YangYangyou-Zhang/OpenblH743VIT6/PPT/H743MINI_back.png

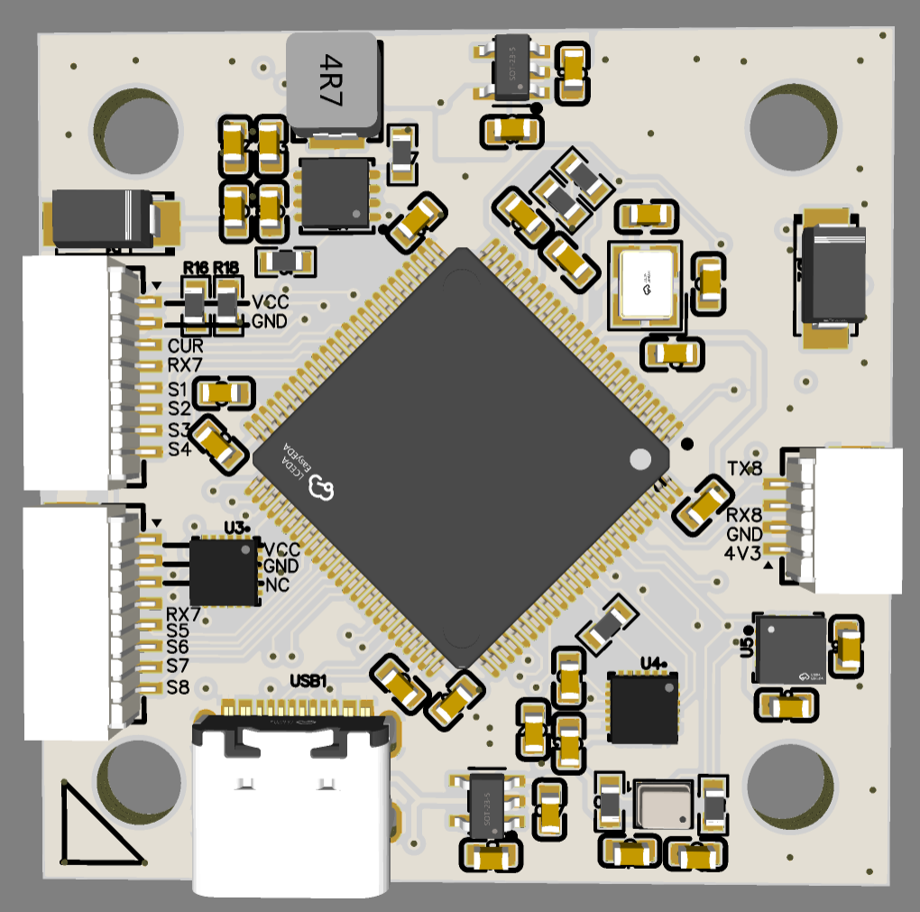
PPT/H743MINI_back.png
