YangYangyou-Zhang/OpenblH743VIT6/PPT/H743MINI_top.png

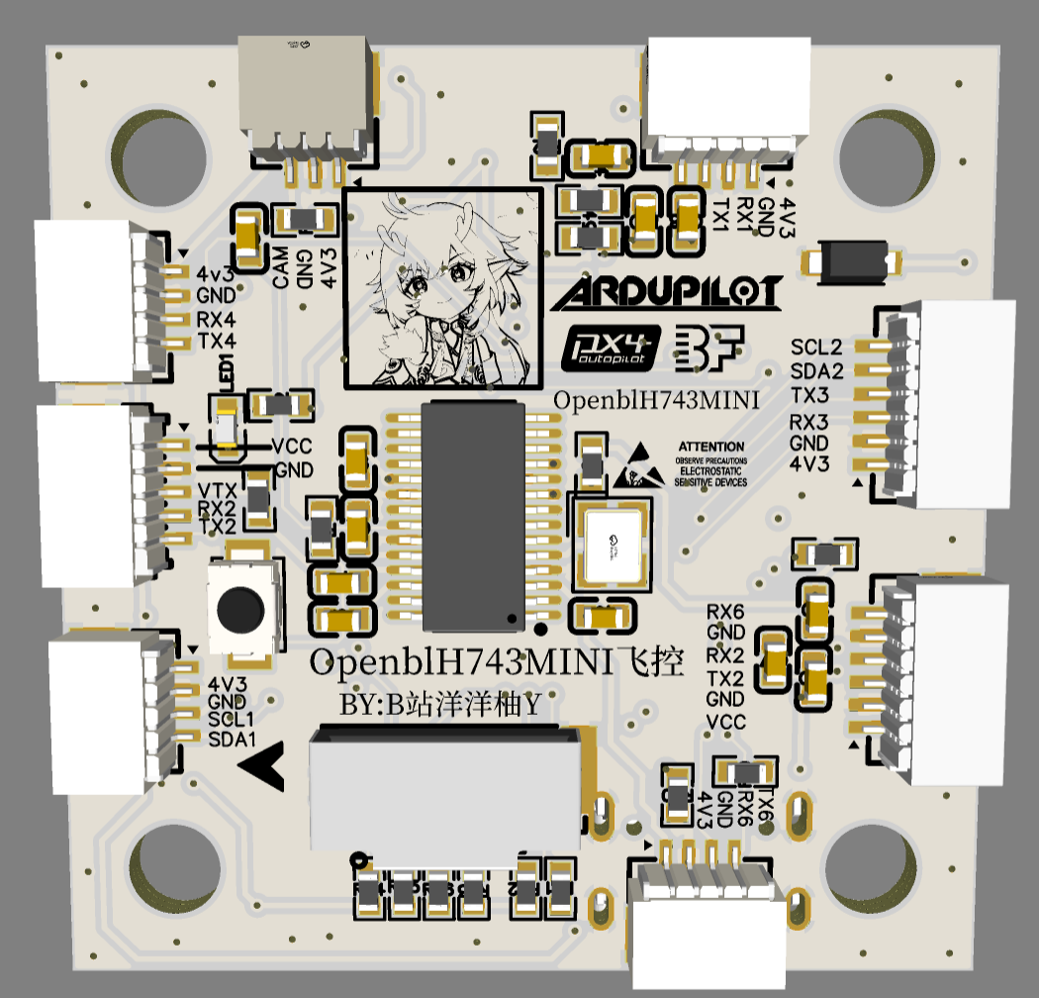
PPT/H743MINI_top.png
