YangYangyou-Zhang/OpenblH743VIT6/PPT/H743VIT6_back.png

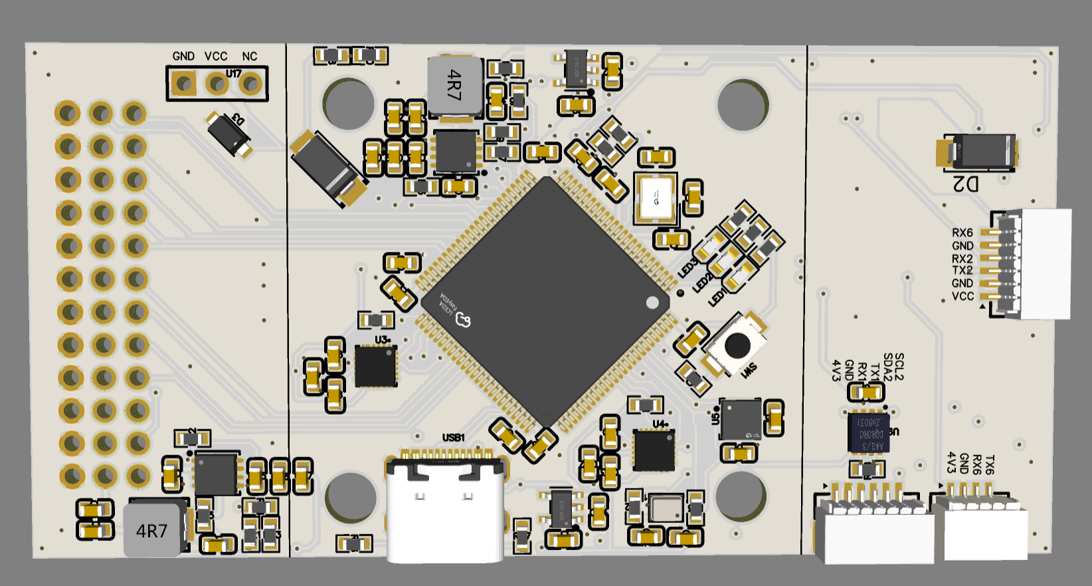
PPT/H743VIT6_back.png
