YangYangyou-Zhang/OpenblH743VIT6/PPT/H743VIT6_top.png

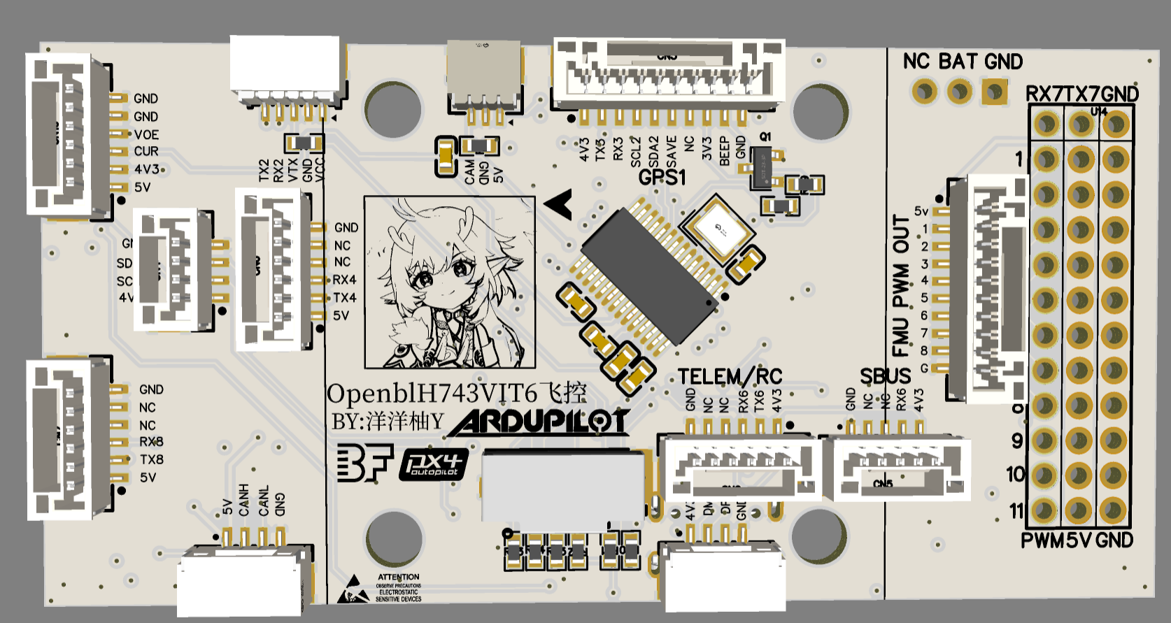
PPT/H743VIT6_top.png
