YangYangyou-Zhang/OpenblH743VIT6/Circuit_diagram电路图/BOM_OpenblH743MINI飞控板_2026-09-29.csv

ID | Name | Designator | Footprint | Quantity | Manufacturer Part | Manufacturer | Supplier | Supplier Part | Price
1 | SMFJ26CA | D2 | SMA_L4.3-W2.6-LS5.2-RD | 1 | SS56 | MDD(辰达半导体) | LCSC | C65009 | 0.323
2 | 10k | R3,R9,R10,R11,R5,R7,R8,R21,R22,R23,R24,R25,R26 | R0603 | 13
3 | 1k | R6,R18,R2 | R0603 | 3
4 | 1M | R13 | R0603 | 1
5 | 51k | R15,R16 | R0603 | 2
6 | 20r | R17 | R0603 | 1
7 | BX-SH1.0-4PWT | U12,U9,U11,U14,U8 | CONN-SMD_4P-P1.00_BX-SH1.0-4PWT | 5 | BX-SH1.0-4PWT | Bossie(博锡) | LCSC | C18077910 | 0.3961
8 | BX-SH1.0-8PWT | U16,U19 | CONN-SMD_8P-P1.00_BX-SH1.0-8PWT | 2 | BX-SH1.0-8PWT | Bossie(博锡) | LCSC | C18077914 | 0.6031
9 | 1u | C28,C35,C36,C37,C38 | C0603 | 5
10 | 100nf | C1,C2,C5,C6,C7,C8,C10,C12,C13,C16,C17,C18,C20,C21,C22,C23,C24,C25,C27,C31,C34 | C0603 | 21
11 | 2.2u | C9,C14,C19 | C0603 | 3
12 | 22pf | C11,C15 | C0603 | 2
13 | 10u | C26,C29,C30,C32,C33 | C0603 | 5
14 | 10uH | L1 | IND-SMD_L4.5-W4.1_TMPA0402SP | 1 | TMPC0402HP-100MG-Z02 | TAI-TECH(台庆) | LCSC | C305203 | 1.9166
15 | ME6211C33M5G-N | LDO1,LDO2 | SOT-23-5_L3.0-W1.7-P0.95-LS2.8-BL | 2 | ME6211C33M5G-N | MICRONE(南京微盟) | LCSC | C82942 | 0.3732
16 | STM32H743VIT6 | U2 | LQFP-100_L14.0-W14.0-P0.50-LS16.0-BL | 1 | STM32H743VIT6 | ST(意法半导体) | LCSC | C529058 | 46.39
17 | MPU6500 | U3,U4 | QFN-24_L3.0-W3.0-P0.40-BL-EP | 2 | MPU-6500 | TDK InvenSense(应美盛) | LCSC | C50278 | 32.58
18 | KH-TYPEC-16P | USB1 | USB-TYPEC-16P | 1
19 | 8MHz | X2 | CRYSTAL-SMD_4P-L3.2-W2.5-BL | 1 | XL2EL89CSI-KPIYLC-8M | YXC(扬兴晶振) | LCSC | C42400161 | 0.8126
20 | SS56 | D1 | SMA_L4.3-W2.6-LS5.2-RD | 1 | SS56 | MDD(辰达半导体) | LCSC | C65009 | 0.323
21 | QMC5883P | U5 | LGA-16_L3.0-W3.0-P0.50-BL_SQ | 1 | QMC5883P | QST(上海矽睿) | LCSC | C2847467 | 9.73
22 | SPL06-001 | U6 | SENSOR-SMD_SPL06-001 | 1 | SPL06-001 | Goertek(歌尔) | LCSC | C2684428 | 6.21
23 | MP9943GQ-Z | U7 | QFN-8_L3.0-W3.0-P0.65-BL | 1 | MP9943GQ-Z | MPS(芯源) | LCSC | C477821 | 17
24 | SMFJ26CA | D3 | SOD-123FL_L2.6-W1.7-LS3.6-BI | 1 | SMFJ26CA | RUILON(瑞隆源) | LCSC | C434860 | 1.0102
25 | 9.53k | R14 | R0603 | 1
26 | 75r | R1,R4 | R0603 | 2
27 | 41.2k | R12 | R0603 | 1
28 | 5.1k | R19,R20 | R0603 | 2
29 | BX-SH1.0-6PWT | U10,U17 | CONN-SMD_6P-P1.00_BX-SH1.0-6PWT | 2 | BX-SH1.0-6PWT | Bossie(博锡) | LCSC | C18077912 | 0.5119
30 | HYCW103-TF08-375B | U13 | TF-SMD_TF-021B-H265 | 1 | HYCW103-TF08-375B | 华宇创 | LCSC | C2962028 | 0.9181
31 | BX-SH1.0-5PWT | U15 | CONN-SMD_5P-P1.00_BX-SH1.0-5PWT | 1 | BX-SH1.0-5PWT | Bossie(博锡) | LCSC | C18077911 | 0.3558
32 | BX-SH1.0-3PWT | U18 | CONN-SMD_3P-P1.00_BX-SH1.0-3PWT | 1 | BX-SH1.0-3PWT | Bossie(博锡) | LCSC | C18077909 | 0.272
33 | 10uf | C3,C4 | C0603 | 2 | CGA0603X5R476M6R3JT | HRE(芯声) | LCSC | C6119831 | 0.7204
34 | AT7456E | U1 | TSSOP-28_L9.7-W4.4-P0.65-LS6.4-BL-EP-2 | 1 | AT7456E | 杭州中科微 | LCSC | C82351 | 21.02
35 | 27MHz-8pf | X1 | CRYSTAL-SMD_4P-L3.2-W2.5-BL | 1 | TAXM27M4RLBCCT2T | YJX(雅晶鑫) | LCSC | C164042 | 0.4455
36 | TS-1088-AR02016 | SW1 | SW-SMD_L3.9-W3.0-P4.45 | 1 | TS-1088-AR02016 | XUNPU(讯普) | LCSC | C720477 | 0.33
37 | LED_r | LED1 | LED0603-RD_1 | 1 | LED灯,0603 | null | LCSC | C9900014849
