YangYangyou-Zhang/OpenblH743VIT6/Circuit_diagram电路图/BOM_OpenblH743VIT6飞控板_2026-09-29.csv

ID | Name | Designator | Footprint | Quantity | Manufacturer Part | Manufacturer | Supplier | Supplier Part | Price
1 | ZX-GH1.25-4PLT | CN4 | CONN-SMD_ZX-GH1.25-4PLT | 1 | ZX-GH1.25-4PLT | Megastar(兆星) | LCSC | C46970427 | 0.5655
2 | ZX-GH1.25-6PLT | CN6,CN10,CN7,CN8 | CONN-SMD_ZX-GH1.25-6PLT | 4 | ZX-GH1.25-6PLT | Megastar(兆星) | LCSC | C46970429 | 0.6317
3 | ZX-GH1.25-10PLT | CN3,CN9 | CONN-SMD_ZX-GH1.25-10PLT | 2 | ZX-GH1.25-10PLT | Megastar(兆星) | LCSC | C46970433 | 0.8635
4 | ZX-GH1.25-4PWT | CN1,CN2 | CONN-SMD_ZX-GH1.25-4PWT | 2 | ZX-GH1.25-4PWT | Megastar(兆星) | LCSC | C46533577 | 0.4947
5 | 100nf | C1,C2,C5,C6,C7,C8,C10,C12,C13,C16,C17,C18,C20,C21,C22,C23,C24,C25,C27,C31,C34,C38,C41,C46 | C0603 | 24
6 | 10uf | C3,C4 | C0603 | 2 | CGA0603X5R476M6R3JT | HRE(芯声) | LCSC | C6119831 | 0.7204
7 | AT7456E | U1 | TSSOP-28_L9.7-W4.4-P0.65-LS6.4-BL-EP-2 | 1 | AT7456E | 杭州中科微 | LCSC | C82351 | 21.02
8 | 27MHz-8pf | X1 | CRYSTAL-SMD_4P-L3.2-W2.5-BL | 1 | TAXM27M4RLBCCT2T | YJX(雅晶鑫) | LCSC | C164042 | 0.4455
9 | 75r | R2,R6 | R0603 | 2
10 | 10k | R7,R30,R31,R32,R33,R34,R35,R5,R9,R10,R11,R12,R13 | R0603 | 13
11 | BX-SH1.0-5PWT | U13 | CONN-SMD_5P-P1.00_BX-SH1.0-5PWT | 1 | BX-SH1.0-5PWT | Bossie(博锡) | LCSC | C18077911 | 0.3558
12 | BX-SH1.0-3PWT | U16 | CONN-SMD_3P-P1.00_BX-SH1.0-3PWT | 1 | BX-SH1.0-3PWT | Bossie(博锡) | LCSC | C18077909 | 0.272
13 | HYCW103-TF08-375B | U11 | TF-SMD_TF-021B-H265 | 1 | HYCW103-TF08-375B | 华宇创 | LCSC | C2962028 | 0.9181
14 | S9014 | Q1 | SOT-23-3_L2.9-W1.3-P1.90-LS2.4-BR | 1 | S9014 | CJ(江苏长电/长晶) | LCSC | C2148 | 0.0786
15 | 1k | R29,R20,R1,R3,R4,R8 | R0603 | 6
16 | HC-GH1.25-5PLT | CN5 | CONN-SMD_HC-GH1.25-5PLT | 1 | HC-GH1.25-5PLT | HC(虹成电子) | LCSC | C53151909 | 0.3944
17 | 直插2.54 | U14 | 3*12PIN_2.54 | 1
18 | SS56 | D2,D1 | SMA_L4.3-W2.6-LS5.2-RD | 2 | SS56 | MDD(辰达半导体) | LCSC | C65009 | 0.323
19 | SMFJ26CA | D3 | SOD-123FL_L2.6-W1.7-LS3.6-BI | 1 | SMFJ26CA | RUILON(瑞隆源) | LCSC | C434860 | 1.0102
20 | 9.53k | R16 | R0603 | 1
21 | BX-SH1.0-6PWT | U10,U15 | CONN-SMD_6P-P1.00_BX-SH1.0-6PWT | 2 | BX-SH1.0-6PWT | Bossie(博锡) | LCSC | C18077912 | 0.5119
22 | BX-SH1.0-4PWT | U12 | CONN-SMD_4P-P1.00_BX-SH1.0-4PWT | 1 | BX-SH1.0-4PWT | Bossie(博锡) | LCSC | C18077910 | 0.3961
23 | 2.2u | C9,C14,C19 | C0603 | 3
24 | 22pf | C11,C15 | C0603 | 2
25 | 10u | C26,C29,C30,C32,C33,C36,C37,C39,C40 | C0603 | 9
26 | 10uH | L1,L2 | IND-SMD_L4.5-W4.1_TMPA0402SP | 2 | TMPC0402HP-100MG-Z02 | TAI-TECH(台庆) | LCSC | C305203 | 1.9166
27 | ME6211C33M5G-N | LDO1,LDO2 | SOT-23-5_L3.0-W1.7-P0.95-LS2.8-BL | 2 | ME6211C33M5G-N | MICRONE(南京微盟) | LCSC | C82942 | 0.3732
28 | LED_b | LED3 | LED0603-RD_1 | 1 | LED灯,0603 | null | LCSC | C9900014849
29 | STM32H743VIT6 | U2 | LQFP-100_L14.0-W14.0-P0.50-LS16.0-BL | 1 | STM32H743VIT6 | ST(意法半导体) | LCSC | C529058 | 46.39
30 | MPU6500 | U3,U4 | QFN-24_L3.0-W3.0-P0.40-BL-EP | 2 | MPU-6500 | TDK InvenSense(应美盛) | LCSC | C50278 | 32.58
31 | 单排母针-2.54mm-3P | U17 | 单排母针-2.54MM-3P | 1 | 单排母针-2.54mm-6P | 单排母针-2.54mm-6P |  | 单排母针-2.54mm-6P
32 | KH-TYPEC-16P | USB1 | USB-TYPEC-16P | 1
33 | 8MHz | X2 | CRYSTAL-SMD_4P-L3.2-W2.5-BL | 1 | XL2EL89CSI-KPIYLC-8M | YXC(扬兴晶振) | LCSC | C42400161 | 0.8126
34 | TS-1088-AR02016 | SW1 | SW-SMD_L3.9-W3.0-P4.45 | 1 | TS-1088-AR02016 | XUNPU(讯普) | LCSC | C720477 | 0.33
35 | 1u | C28,C35,C42,C43,C44,C45 | C0603 | 6
36 | LED_r | LED1 | LED0603-RD_1 | 1 | LED灯,0603 | null | LCSC | C9900014849
37 | LED_g | LED2 | LED0603-RD_1 | 1 | LED灯,0603 | null | LCSC | C9900014849
38 | 41.2k | R14,R21 | R0603 | 2
39 | 1M | R15,R22 | R0603 | 2
40 | 51k | R17,R18,R24 | R0603 | 3
41 | 20r | R19,R25 | R0603 | 2
42 | 7.68k | R23 | R0603 | 1
43 | 5.1k | R26,R27 | R0603 | 2
44 | 120 | R28 | R0603 | 1
45 | QMC5883P | U5 | LGA-16_L3.0-W3.0-P0.50-BL_SQ | 1 | QMC5883P | QST(上海矽睿) | LCSC | C2847467 | 9.73
46 | SPL06-001 | U6 | SENSOR-SMD_SPL06-001 | 1 | SPL06-001 | Goertek(歌尔) | LCSC | C2684428 | 6.21
47 | MP9943GQ-Z | U7,U8 | QFN-8_L3.0-W3.0-P0.65-BL | 2 | MP9943GQ-Z | MPS(芯源) | LCSC | C477821 | 17
48 | TJA1051TK/3,118 | U9 | HVSON-8_L3.0-W3.0-P0.65-BL-EP | 1 | TJA1051TK/3,118 | NXP(恩智浦) | LCSC | C124020 | 11.72
