YangYangyou-Zhang/OpenblH743VIT6/STL图纸/OpenblH743.SLDPRT

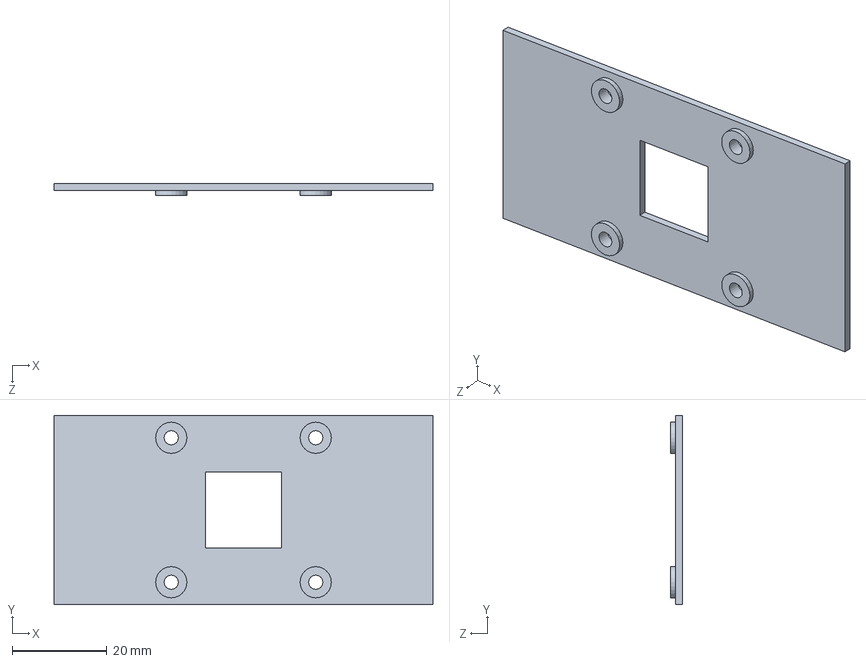
[picture p9: CAD file, 2026-10-23]
STL图纸/OpenblH743.SLDPRT
80.0 x 40.0 x 2.50 mm
