YangYangyou-Zhang/OpenblH743VIT6/STL图纸/钢网框4-8.SLDPRT

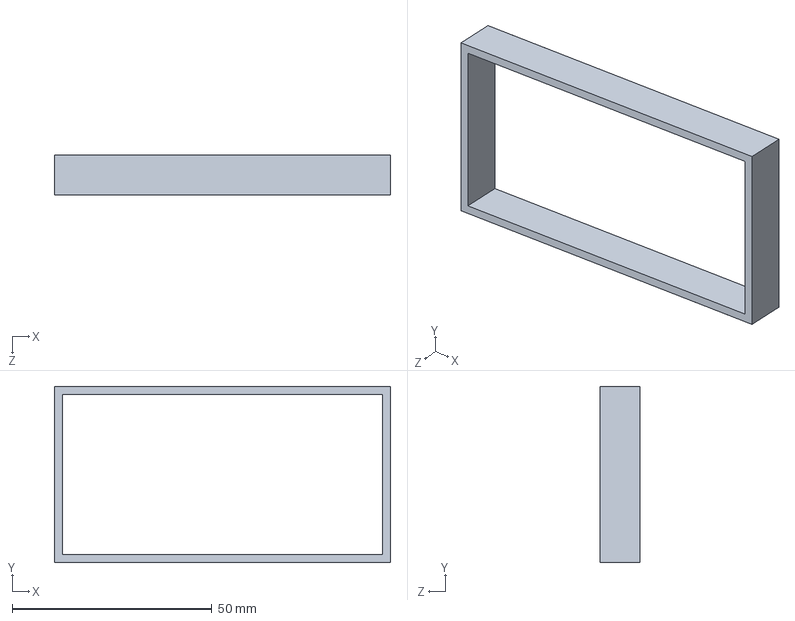
[picture p10: CAD file, 2026-10-23]
STL图纸/钢网框4-8.SLDPRT
84.2 x 44.2 x 10.0 mm
