YangYangyou-Zhang/OpenblH743VIT6/STL图纸/OpenblH743_3507_L.SLDPRT

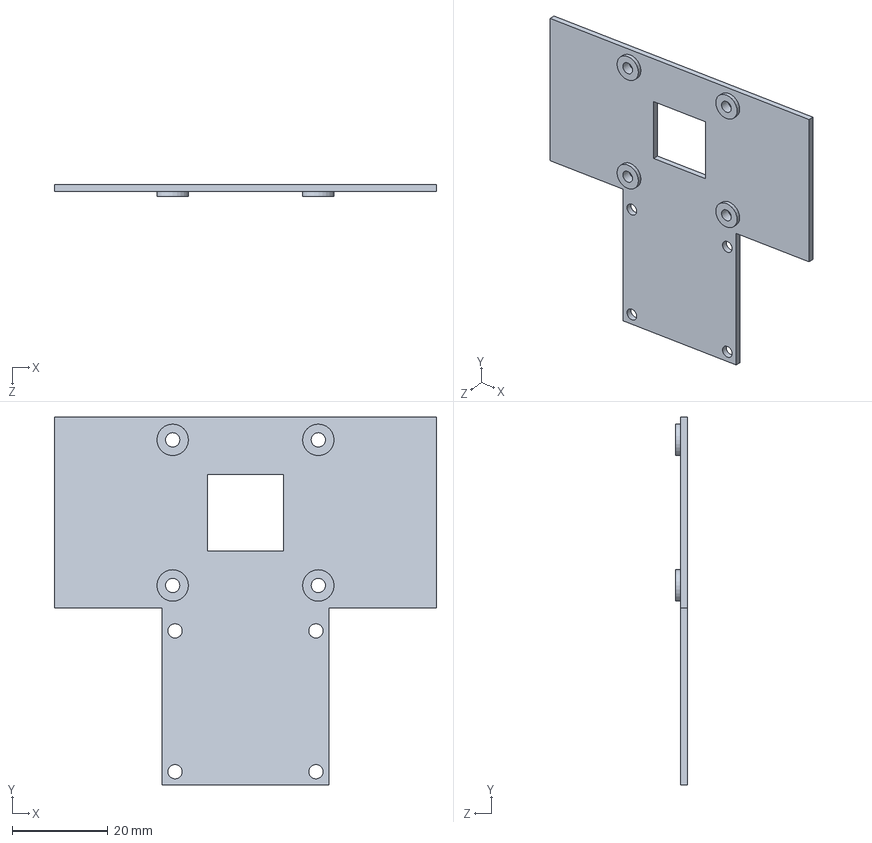
[picture p11: CAD file, 2026-10-23]
STL图纸/OpenblH743_3507_L.SLDPRT
80.0 x 77.0 x 2.50 mm
