YangYangyou-Zhang/OpenblH743VIT6/STL图纸/OpenblH743_3507.SLDPRT

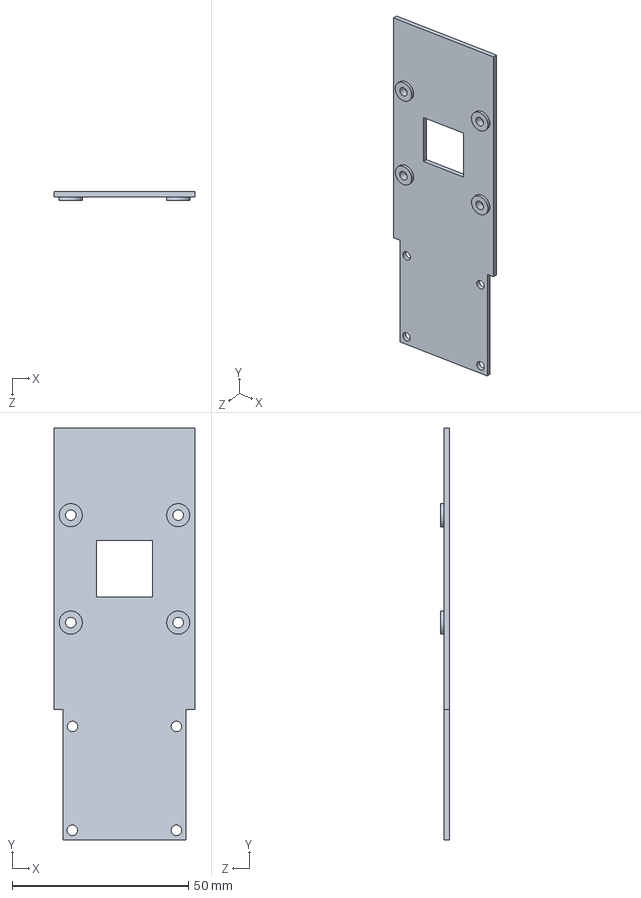
[picture p13: CAD file, 2026-10-23]
STL图纸/OpenblH743_3507.SLDPRT
40.0 x 117.0 x 2.50 mm
