YangYangyou-Zhang/OpenblH743VIT6/(list of files, cad)

Other CAD files:
STL图纸/OpenblH743.STL
STL图纸/OpenblH743_3507.STL
STL图纸/OpenblH743_3507_L.STL
STL图纸/钢网框4-4.STL
STL图纸/钢网框4-8.STL
