YangYangyou-Zhang/OpenblH743VIT6/firmware固件/src编译源代码资料/INAV/how_to_build_en.txt

# Copyright (c) 2026 洋洋柚 (@zhangyangyangyou)
# OpenblH743VIT6 — custom STM32H743VIT6 flight controller board.
# Update the system and install required tools
sudo apt-get update && sudo apt-get upgrade
sudo apt-get install git make ruby cmake gcc-arm-none-eabi
# INAV 9.0.1 expects arm-none-eabi-gcc 13.2.1 (see cmake/toolchain-arm-none-eabi.cmake);
# Ruby is required by the build. Install a matching toolchain if the system one differs.

# Clone the iNav source code
git clone https://github.com/iNavFlight/inav.git
cd inav

# Place the OpenblH743VIT6 folder under src/main/target/.

# Create the build directory and build the target
mkdir -p build
cmake -B build -DCMAKE_TOOLCHAIN_FILE=cmake/toolchain-arm-none-eabi.cmake
cmake --build build --target OpenblH743VIT6 -j4

# Output: build/inav_9.0.1_OpenblH743VIT6.hex

# ===== Key notes (see OpenblH743VIT6/README_en.md for details) =====
# - IMU orientation: CW90_DEG_FLIP
# - SPL06 0x77 / QMC5883P 0x2C, both on I2C1 (PB6/PB7)
# - SD card slowed down (SDCARD_SDIO_NORMAL_SPEED); if it still fails it is a hardware issue
# - Dual IMU switching via gyro_to_use (0=first SPI2, 1=second SPI3)
# - No CAN support in the INAV target
# - PB0/PB1 are PWM 11/12 (VIT6); the fp variant uses PB0 as a buzzer
# - Flash layout: 0x08000000 vector / 0x08020000 config / 0x08040000 firmware;
#   flashing INAV overwrites the APM bootloader — full chip erase, reflash the bootloader to return to PX4/APM
# - Interface map: PPT/annotated/ and PPT/interface_map_en.md
