YangYangyou-Zhang/OpenblH743VIT6/firmware固件/src编译源代码资料/Betafight/how_to_build_en.txt

# Copyright (c) 2026 洋洋柚 (@zhangyangyangyou)
# OpenblH743VIT6 — custom STM32H743VIT6 flight controller board.
# Update the package list and upgrade the system
sudo apt update && sudo apt upgrade

# Install base build tools
# You need git (for cloning), make (for building), clang (needed for some tests) and python, etc.
sudo apt -y install build-essential git curl clang-18 python3 python-is-python3

# Clone the Betaflight source code
git clone https://github.com/betaflight/betaflight.git

# Enter the source directory
cd betaflight

# Check out a stable version (e.g. 4.5.3)
git checkout 4.5.3

# Apply the local SPL06 barometer patch (from the Betafight folder)
cp -r <repo>/firmware固件/src编译源代码资料/Betafight/patches/drivers/barometer/* src/main/drivers/barometer/
cp -r <repo>/firmware固件/src编译源代码资料/Betafight/patches/drivers/compass/*   src/main/drivers/compass/
cp -r <repo>/firmware固件/src编译源代码资料/Betafight/patches/sensors/*           src/main/sensors/
cp    <repo>/firmware固件/src编译源代码资料/Betafight/patches/cli/settings.c      src/main/cli/

# Place the OpenblH743VIT6 folder under src/config/configs/
# Do NOT run "make configs" with 4.5.3 (it clones GitHub's betaflight/config repo).

# Build with an existing GCC 10.x toolchain (official 4.5.3 requires 10.3.1; override the check)
make OpenblH743VIT6 ARM_SDK_DIR=$HOME/gcc-arm-none-eabi-10-2020-q4-major GCC_REQUIRED_VERSION=10.2.1 -j32

# Find the built firmware betaflight_4.5.3_STM32H743_OpenblH743VIT6.hex under ~/betaflight/obj

# ===== Key notes (see OpenblH743VIT6/README.md and patches/README.md) =====
# - HSE crystal 8MHz: SYSTEM_HSE_MHZ 8 in config.h
# - IMU orientation: CW90_DEG_FLIP
# - SPL06 barometer: supported via the local patch; USE_BARO / USE_BARO_SPL06 are enabled in config.h
# - QMC5883P magnetometer: supported via the local patch; USE_MAG / USE_MAG_QMC5883P are enabled
# - SD card: not yet supported; USE_SDCARD remains commented out
# - After flashing, run defaults + save in the CLI once (otherwise the IMU orientation reads the old config value)
