YangYangyou-Zhang/OpenblH743VIT6/firmware固件/src编译源代码资料/Betafight/OpenblH743VIT6/config.h

/*
 * This file is part of Betaflight.
 *
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
 * See the GNU General Public License for more details.
 *
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
 * If not, see <http://www.gnu.org/licenses/>.
 */
/*
 * Copyright (c) 2026 洋洋柚 (@zhangyangyangyou)
 * OpenblH743VIT6 target, modified from the Betaflight/INAV unified
 * target template. Licensed under GPL-3.0 as above.
 */


#pragma once

#define FC_TARGET_MCU     STM32H743

#define BOARD_NAME        OpenblH743VIT6
#define MANUFACTURER_ID   OPBL

#define USE_ACC
#define USE_GYRO
#define USE_ACC_SPI_MPU6500
#define USE_GYRO_SPI_MPU6500
#define USE_BARO
// #define USE_BARO_BMP280
#define USE_BARO_SPL06          // SPL06 on I2C1 (PB6/PB7), 0x77; needs the driver patch in ../patches
#define USE_MAG
#define USE_MAG_QMC5883P
#define MAG_QMC5883P_ALIGN CW270_DEG_FLIP  // matches PX4 -R 10 (ROLL_180_YAW_90); verify by compass calibration
// #define USE_MAG_QMC5883
// #define QMC5883L_MAG_I2C_ADDRESS  0x2C
#define USE_MAX7456
// #define USE_SDCARD
// #define USE_SDCARD_SDIO

// Motor / PWM outputs.
// NOTE: PB0 was the passive buzzer in the APM hwdef. The buzzer shares TIM3 with
// PB1 (MOTOR11); a tone beeper would reconfigure TIM3 and break the motor, so it is
// left as a 12th PWM output instead (matches the PX4 decision).
#define MOTOR1_PIN           PE9
#define MOTOR2_PIN           PE11
#define MOTOR3_PIN           PE13
#define MOTOR4_PIN           PE14
#define MOTOR5_PIN           PD12
#define MOTOR6_PIN           PD13
#define MOTOR7_PIN           PD14
#define MOTOR8_PIN           PD15
#define MOTOR9_PIN           PE5
#define MOTOR10_PIN          PE6
#define MOTOR11_PIN          PB1
#define MOTOR12_PIN          PB0

#define UART1_TX_PIN         PA9
#define UART1_RX_PIN         PA10
#define UART2_TX_PIN         PA2
#define UART2_RX_PIN         PA3
#define UART3_TX_PIN         PD8
#define UART3_RX_PIN         PD9
#define UART4_TX_PIN         PA0
#define UART4_RX_PIN         PA1
#define UART6_TX_PIN         PC6
#define UART6_RX_PIN         PC7
#define UART7_TX_PIN         PE8
#define UART7_RX_PIN         PE7
#define UART8_TX_PIN         PE1
#define UART8_RX_PIN         PE0

#define I2C1_SCL_PIN         PB6
#define I2C1_SDA_PIN         PB7
#define I2C2_SCL_PIN         PB10
#define I2C2_SDA_PIN         PB11

#define LED0_PIN             PE3
#define LED1_PIN             PE2

#define SPI1_SCK_PIN         PA5
#define SPI1_SDI_PIN         PA6
#define SPI1_SDO_PIN         PA7
#define SPI2_SCK_PIN         PB13
#define SPI2_SDI_PIN         PB14
#define SPI2_SDO_PIN         PB15
#define SPI3_SCK_PIN         PB3
#define SPI3_SDI_PIN         PB4
#define SPI3_SDO_PIN         PD6

#define ADC_VBAT_PIN         PC0
#define ADC_CURR_PIN         PC1

#define MAX7456_SPI_CS_PIN   PC4
#define MAX7456_SPI_INSTANCE SPI1

#define GYRO_1_CS_PIN        PB12
#define GYRO_1_SPI_INSTANCE  SPI2
#define GYRO_1_ALIGN         CW90_DEG_FLIP
#define GYRO_2_CS_PIN        PD7
#define GYRO_2_SPI_INSTANCE  SPI3
#define GYRO_2_ALIGN         CW90_DEG_FLIP

// TIMER_PIN_MAP(id, pin, occurrence, dmaopt)
//  - occurrence: 1-based index of the timer AF on that pin in fullTimerHardware
//  - dmaopt:     DMA stream index (0-7 = DMA1 Stream0-7, 8-15 = DMA2 Stream0-7, -1 = none)
// TIM4_CH4 (PD15) and TIM15_CH2 (PE6) have no timer DMA on H7.
#define TIMER_PIN_MAPPING \
    TIMER_PIN_MAP( 0, MOTOR1_PIN , 1,  8) \
    TIMER_PIN_MAP( 1, MOTOR2_PIN , 1,  9) \
    TIMER_PIN_MAP( 2, MOTOR3_PIN , 1, 10) \
    TIMER_PIN_MAP( 3, MOTOR4_PIN , 1, 11) \
    TIMER_PIN_MAP( 4, MOTOR5_PIN , 1,  0) \
    TIMER_PIN_MAP( 5, MOTOR6_PIN , 1,  1) \
    TIMER_PIN_MAP( 6, MOTOR7_PIN , 1,  2) \
    TIMER_PIN_MAP( 7, MOTOR8_PIN , 1, -1) \
    TIMER_PIN_MAP( 8, MOTOR9_PIN , 1, 12) \
    TIMER_PIN_MAP( 9, MOTOR10_PIN, 1, -1) \
    TIMER_PIN_MAP(10, MOTOR11_PIN, 2,  3) \
    TIMER_PIN_MAP(11, MOTOR12_PIN, 2,  4)

#define ADC1_DMA_OPT                 8
#define ADC3_DMA_OPT                 9

#define MAG_I2C_INSTANCE             I2CDEV_1
#define BARO_I2C_INSTANCE            I2CDEV_1

#define DEFAULT_BLACKBOX_DEVICE      BLACKBOX_DEVICE_SDCARD
#define DEFAULT_CURRENT_METER_SOURCE CURRENT_METER_ADC
#define DEFAULT_VOLTAGE_METER_SOURCE VOLTAGE_METER_ADC
#define DEFAULT_VOLTAGE_METER_SCALE 110
#define DEFAULT_CURRENT_METER_SCALE 150

#define SYSTEM_HSE_MHZ               8

#define SERIALRX_UART                SERIAL_PORT_USART6
#define DEFAULT_RX_FEATURE           FEATURE_RX_SERIAL
