YangYangyou-Zhang/OpenblH743VIT6/firmware固件/src编译源代码资料/APM/OpenblH743VIT6/hwdef.dat

# Copyright (c) 2026 洋洋柚 (@zhangyangyangyou)
# OpenblH743VIT6 — custom STM32H743VIT6 flight controller board.
# hw definition file for processing by chibios_hwdef.py
# for the OpenblH743VIT6/MINI hardware

# MCU class and specific type
MCU STM32H7xx STM32H743xx

# board ID. See Tools/AP_Bootloader/board_types.txt
APJ_BOARD_ID 18848

# crystal frequency

OSCILLATOR_HZ 8000000

# ChibiOS system timer
STM32_ST_USE_TIMER 12
define CH_CFG_ST_RESOLUTION 16

# flash size
FLASH_SIZE_KB 2048
FLASH_RESERVE_START_KB 128

define HAL_STORAGE_SIZE 32768
STORAGE_FLASH_PAGE 14

# default to all pins low to avoid ESD issues

# order of UARTs (and USB)
SERIAL_ORDER  OTG1 USART1 USART2 USART3 UART4 USART6 UART7 UART8
# - SERIAL0 -> USB
# - SERIAL1 -> UART1 (GPS0, DMA-enabled)
# - SERIAL2 -> UART2 (DisplayPort, DMA-enabled)
# - SERIAL3 -> UART3 (GPS1, DMA-enabled)
# - SERIAL4 -> UART4 (MAVLink2, DMA-enabled)
# - SERIAL5 -> UART6 (RCIN, DMA-enabled)
# - SERIAL6 -> UART7 (RX only, ESC Telemetry, DMA-enabled)
# - SERIAL7 -> UART8 (MAVLink2, DMA-enabled)

# USB
PA11 OTG_FS_DM OTG1
PA12 OTG_FS_DP OTG1

# UARTs
PA9  USART1_TX USART1
PA10 USART1_RX USART1
PA2  USART2_TX USART2
PA3  USART2_RX USART2
PD8  USART3_TX USART3
PD9  USART3_RX USART3
PA0  UART4_TX  UART4
PA1  UART4_RX  UART4
PC6  USART6_TX USART6
PC7  USART6_RX USART6
PE8  UART7_TX  UART7
PE7  UART7_RX  UART7
PE1  UART8_TX  UART8
PE0  UART8_RX  UART8

# SWD
PA13 JTMS-SWDIO SWD
PA14 JTCK-SWCLK SWD

# CAN
PB8 CAN1_RX CAN1
PB9 CAN1_TX CAN1

# order of I2C
I2C_ORDER I2C2 I2C1

# I2C
PB6  I2C1_SCL I2C1
PB7  I2C1_SDA I2C1
PB10 I2C2_SCL I2C2
PB11 I2C2_SDA I2C2

# PWM
PE9  TIM1_CH1  TIM1  PWM(1)  GPIO(53)
PE11 TIM1_CH2  TIM1  PWM(2)  GPIO(52) BIDIR
PE13 TIM1_CH3  TIM1  PWM(3)  GPIO(51)
PE14 TIM1_CH4  TIM1  PWM(4)  GPIO(50) BIDIR

PD12 TIM4_CH1  TIM4  PWM(5)  GPIO(56) BIDIR
PD13 TIM4_CH2  TIM4  PWM(6)  GPIO(57)
PD14 TIM4_CH3  TIM4  PWM(7)  GPIO(60) 
PD15 TIM4_CH4  TIM4  PWM(8)  GPIO(61)

PE5  TIM15_CH1 TIM15 PWM(9)  GPIO(58)
PE6  TIM15_CH2 TIM15 PWM(10) GPIO(59)

# LED-pad
PB1  TIM3_CH4  TIM3  PWM(11)  GPIO(54) #M11

# BUZZER (passive, tone alarm)
PB0  TIM3_CH3 TIM3 GPIO(55) ALARM

# SAFETY SWITCH
PB2 SAFETY_IN INPUT PULLDOWN
define BOARD_SAFETY_ENABLE_DEFAULT 0

# 11 PWM available by default
# LEDs
PE3 LED_RED   OUTPUT LOW GPIO(0)
PE2 LED_GREEN OUTPUT LOW GPIO(1)
PE4 LED_BLUE  OUTPUT LOW GPIO(2)

define AP_NOTIFY_GPIO_LED_RGB_RED_PIN 0
define AP_NOTIFY_GPIO_LED_RGB_GREEN_PIN 1
define AP_NOTIFY_GPIO_LED_RGB_BLUE_PIN 2

define AP_NOTIFY_GPIO_LED_RGB_ENABLED 1

# ADC for Power
PC0 BATT_VOLTAGE_SENS ADC1 SCALE(1) FLOATING
PC1 BATT_CURRENT_SENS ADC1 SCALE(1) FLOATING

# setup for battery
define HAL_BATT_MONITOR_DEFAULT 4
define HAL_BATT_VOLT_PIN 10
define HAL_BATT_CURR_PIN 11
define HAL_BATT_VOLT_SCALE 52
define HAL_BATT_CURR_SCALE 50

# compass
define ALLOW_ARM_NO_COMPASS
define AP_COMPASS_PROBING_ENABLED 1
define HAL_I2C_INTERNAL_MASK 0
define HAL_COMPASS_AUTO_ROT_DEFAULT 2

# microSD support
PC12 SDMMC1_CK  SDMMC1
PD2  SDMMC1_CMD SDMMC1
PC8  SDMMC1_D0  SDMMC1
PC9  SDMMC1_D1  SDMMC1
PC10 SDMMC1_D2  SDMMC1
PC11 SDMMC1_D3  SDMMC1
define FATFS_HAL_DEVICE SDCD1

# SPI1 - OSD
PA5  SPI1_SCK        SPI1
PA6  SPI1_MISO       SPI1
PA7  SPI1_MOSI       SPI1
PC4  AT7456E_CS      CS

# SPI2 - MPU6500
PB13  SPI2_SCK        SPI2
PB14  SPI2_MISO       SPI2
PB15  SPI2_MOSI       SPI2
PB12  IMU0_CS     CS

# SPI3 - MPU6500
PB3  SPI3_SCK      SPI3
PB4  SPI3_MISO     SPI3
PD6  SPI3_MOSI     SPI3
PD7  IMU1_CS       CS

# SPI devices
SPIDEV mpu6500_0    SPI2 DEVID1 IMU0_CS MODE3 1*MHZ 4*MHZ
SPIDEV mpu6500_1    SPI3 DEVID2 IMU1_CS MODE3 1*MHZ 4*MHZ
SPIDEV  osd       SPI1  DEVID3  AT7456E_CS   MODE0  10*MHZ 10*MHZ

# 2 IMUs
IMU Invensense SPI:mpu6500_0 ROTATION_ROLL_180
IMU Invensense SPI:mpu6500_1 ROTATION_ROLL_180

# barometers
BARO BMP280 I2C:1:0x76
BARO BMP280 I2C:1:0x77
BARO SPL06 I2C:1:0x76
BARO SPL06 I2C:1:0x77
define HAL_BARO_ALLOW_INIT_NO_BARO
define AP_BARO_BACKEND_DEFAULT_ENABLED 0
define AP_BARO_BMP280_ENABLED 1
define AP_BARO_SPL06_ENABLED 1

# enable FAT filesystem support (needs a microSD defined via SDMMC)
define HAL_OS_FATFS_IO 1

# setup for serial ports
define DEFAULT_SERIAL2_PROTOCOL SerialProtocol_MSP_DisplayPort
define DEFAULT_SERIAL4_PROTOCOL SerialProtocol_MAVLink2
define DEFAULT_SERIAL4_BAUD 460
define DEFAULT_SERIAL5_PROTOCOL SerialProtocol_RCIN
define DEFAULT_SERIAL6_PROTOCOL SerialProtocol_ESCTelemetry
define DEFAULT_SERIAL7_PROTOCOL SerialProtocol_MAVLink2
define DEFAULT_SERIAL7_BAUD 460

# setup for OSD
define OSD_ENABLED 1
define HAL_OSD_TYPE_DEFAULT 1
ROMFS_WILDCARD libraries/AP_OSD/fonts/font*.bin
