YangYangyou-Zhang/OpenblH743VIT6/firmware固件/src编译源代码资料/PX4/openblh743/src/board_config.h

/****************************************************************************
 *
 *   Copyright (c) 2021 PX4 Development Team. All rights reserved.
 *   Copyright (c) 2026 洋洋柚 (@zhangyangyangyou)
 *   Modified for the OpenblH743VIT6 board.
 *
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
 * 1. Redistributions of source code must retain the above copyright
 *    notice, this list of conditions and the following disclaimer.
 * 2. Redistributions in binary form must reproduce the above copyright
 *    notice, this list of conditions and the following disclaimer in
 *    the documentation and/or other materials provided with the
 *    distribution.
 * 3. Neither the name PX4 nor the names of its contributors may be
 *    used to endorse or promote products derived from this software
 *    without specific prior written permission.
 *
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
 ****************************************************************************/

/**
 * @file board_config.h
 *
 * Board internal definitions
 */

#pragma once

/* Onboard QMC5883P lives on an "external" I2C bus; override so it is
 * treated as an internal sensor (compass calibration reference). */
#define BOARD_OVERRIDE_I2C_DEVICE_EXTERNAL

/****************************************************************************************************
 * Included Files
 ****************************************************************************************************/

#include <px4_platform_common/px4_config.h>
#include <nuttx/compiler.h>
#include <stdint.h>

#include <stm32_gpio.h>

/****************************************************************************************************
 * Definitions
 ****************************************************************************************************/



/* LEDs are driven with push open drain to support Anode to 5V or 3.3V */

#  define GPIO_nLED_RED         /* PE2   */  (GPIO_OUTPUT|GPIO_PUSHPULL|GPIO_SPEED_50MHz|GPIO_OUTPUT_SET|GPIO_PORTE|GPIO_PIN2)
#  define GPIO_nLED_GREEN       /* PE3   */  (GPIO_OUTPUT|GPIO_PUSHPULL|GPIO_SPEED_50MHz|GPIO_OUTPUT_SET|GPIO_PORTE|GPIO_PIN3)
#  define GPIO_nLED_BLUE        /* PE4   */  (GPIO_OUTPUT|GPIO_PUSHPULL|GPIO_SPEED_50MHz|GPIO_OUTPUT_SET|GPIO_PORTE|GPIO_PIN4)

#  define BOARD_HAS_CONTROL_STATUS_LEDS      1
#  define BOARD_OVERLOAD_LED     LED_BLUE
#  define BOARD_ARMED_STATE_LED  LED_RED
#  define BOARD_ARMED_LED        LED_RED


/*
 * ADC channels
 *
 * These are the channel numbers of the ADCs of the microcontroller that
 * can be used by the Px4 Firmware in the adc driver
 */

/* ADC defines to be used in sensors.cpp to read from a particular channel */
#define SYSTEM_ADC_BASE STM32_ADC1_BASE
#define ADC1_CH(n)                  (n)

/* Define GPIO pins used as ADC N.B. Channel numbers must match below  */
#define PX4_ADC_GPIO  \
	/* PC0  */  GPIO_ADC123_INP10, \
	/* PC1  */  GPIO_ADC123_INP11


/* Define Channel numbers must match above GPIO pin IN(n)*/
#define ADC_BATTERY_VOLTAGE_CHANNEL     /* PC0  */  ADC1_CH(10)
#define ADC_BATTERY_CURRENT_CHANNEL     /* PC1  */  ADC1_CH(11)


#define ADC_CHANNELS \
	((1 << ADC_BATTERY_VOLTAGE_CHANNEL) | \
	 (1 << ADC_BATTERY_CURRENT_CHANNEL))


/* Define Battery 1 Voltage Divider and A per V
 */

// #define BOARD_BATTERY1_V_DIV         (11.0f)     /* measured with the provided PM board */
// #define BOARD_BATTERY1_A_PER_V       (40.0f)
// #define BOARD_BATTERY2_V_DIV         (11.0f)     /* measured with the provided PM board */


/* PWM
 */
#define DIRECT_PWM_OUTPUT_CHANNELS   12
#define DIRECT_INPUT_TIMER_CHANNELS  10

#define BOARD_HAS_PWM  DIRECT_PWM_OUTPUT_CHANNELS

#define GPIO_BTN_SAFETY         /* PB2 */ (GPIO_INPUT|GPIO_PULLDOWN|GPIO_PORTB|GPIO_PIN2)

/* USB OTG FS
 *
 * PA8  OTG_FS_VBUS VBUS sensing
 */

#define GPIO_OTGFS_VBUS         /* PA8 */ (GPIO_INPUT|GPIO_PULLDOWN|GPIO_SPEED_100MHz|GPIO_PORTA|GPIO_PIN8)
#define BOARD_ADC_USB_CONNECTED (px4_arch_gpioread(GPIO_OTGFS_VBUS))


/* High-resolution timer */
#define HRT_TIMER               2  /* use timer8 for the HRT */
#define HRT_TIMER_CHANNEL       1  /* use capture/compare channel 3 */


/* RC Serial port */
#define RC_SERIAL_PORT          "/dev/ttyS5"
#define BOARD_SUPPORTS_RC_SERIAL_PORT_OUTPUT

#define GPIO_I2C2_DRDY1_SPL06      /* PD0  */  (GPIO_INPUT|GPIO_FLOAT|GPIO_EXTI|GPIO_PORTD|GPIO_PIN0)


/* SD Card */
#define SDIO_SLOTNO             0  /* Only one slot */
#define SDIO_MINOR              0

/* This board provides a DMA pool and APIs */
#define BOARD_DMA_ALLOC_POOL_SIZE 5120

/* This board provides the board_on_reset interface */
#define BOARD_HAS_ON_RESET 1

#define PX4_GPIO_INIT_LIST { \
		PX4_ADC_GPIO, \
		GPIO_BTN_SAFETY,                  \
		GPIO_CAN1_TX, \
		GPIO_CAN1_RX, \
	}

#define BOARD_ENABLE_CONSOLE_BUFFER


#define BOARD_NUM_IO_TIMERS 5


__BEGIN_DECLS

/****************************************************************************************************
 * Public Types
 ****************************************************************************************************/

/****************************************************************************************************
 * Public data
 ****************************************************************************************************/

#ifndef __ASSEMBLY__

/****************************************************************************************************
 * Public Functions
 ****************************************************************************************************/

/****************************************************************************
 * Name: stm32_sdio_initialize
 *
 * Description:
 *   Initialize SDIO-based MMC/SD card support
 *
 ****************************************************************************/

int stm32_sdio_initialize(void);

/****************************************************************************************************
 * Name: stm32_spiinitialize
 *
 * Description:
 *   Called to configure SPI chip select GPIO pins for the board.
 *
 ****************************************************************************************************/

extern void stm32_spiinitialize(void);

extern void stm32_usbinitialize(void);

extern void board_peripheral_reset(int ms);

#include <px4_platform_common/board_common.h>

#endif /* __ASSEMBLY__ */

__END_DECLS
