YangYangyou-Zhang/OpenblH743VIT6/firmware固件/src编译源代码资料/APM/OpenblH743VIT6/hwdef-bl.dat

# Copyright (c) 2026 洋洋柚 (@zhangyangyangyou)
# OpenblH743VIT6 — custom STM32H743VIT6 flight controller board.
# hw definition file for processing by chibios_hwdef.py
# for OpenblH743VIT6 bootloader

# MCU class and specific type
MCU STM32H7xx STM32H743xx

# board ID. See Tools/AP_Bootloader/board_types.txt
APJ_BOARD_ID 18848

# crystal frequency, setup to use external oscillator
OSCILLATOR_HZ 8000000
FLASH_RESERVE_END_KB 0

FLASH_SIZE_KB 2048

# bootloader starts at zero offset
FLASH_RESERVE_START_KB 0

# the location where the bootloader will put the firmware
# the H743 has 128k sectors
FLASH_BOOTLOADER_LOAD_KB 128

# order of UARTs (and USB). Allow bootloading on USB
SERIAL_ORDER OTG1

# USB
PA11 OTG_FS_DM OTG1
PA12 OTG_FS_DP OTG1

# LED
PE4 LED_BOOTLOADER OUTPUT LOW
define HAL_LED_ON 0

# Add CS pins to ensure they are high in bootloader
PB12 IMU0_CS CS
PD7  IMU1_CS CS
PC4  AT7456E_CS CS
