YangYangyou-Zhang/OpenblH743VIT6/firmware固件/src编译源代码资料/PX4/shared_src/src/drivers/imu/invensense/icm42605/ICM42605.cpp

/****************************************************************************
 *
 *   Copyright (c) 2020-2021 PX4 Development Team. All rights reserved.
 *
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
 * 1. Redistributions of source code must retain the above copyright
 *    notice, this list of conditions and the following disclaimer.
 * 2. Redistributions in binary form must reproduce the above copyright
 *    notice, this list of conditions and the following disclaimer in
 *    the documentation and/or other materials provided with the
 *    distribution.
 * 3. Neither the name PX4 nor the names of its contributors may be
 *    used to endorse or promote products derived from this software
 *    without specific prior written permission.
 *
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
 ****************************************************************************/

#include "ICM42605.hpp"

using namespace time_literals;

static constexpr int16_t combine(uint8_t msb, uint8_t lsb)
{
	return (msb << 8u) | lsb;
}

ICM42605::ICM42605(const I2CSPIDriverConfig &config) :
	SPI(config),
	I2CSPIDriver(config),
	_drdy_gpio(config.drdy_gpio),
	_px4_accel(get_device_id(), config.rotation),
	_px4_gyro(get_device_id(), config.rotation)
{
	if (config.drdy_gpio != 0) {
		_drdy_missed_perf = perf_alloc(PC_COUNT, MODULE_NAME": DRDY missed");
	}

	ConfigureSampleRate(_px4_gyro.get_max_rate_hz());
}

ICM42605::~ICM42605()
{
	perf_free(_bad_register_perf);
	perf_free(_bad_transfer_perf);
	perf_free(_fifo_empty_perf);
	perf_free(_fifo_overflow_perf);
	perf_free(_fifo_reset_perf);
	perf_free(_drdy_missed_perf);
}

int ICM42605::init()
{
	int ret = SPI::init();

	if (ret != PX4_OK) {
		DEVICE_DEBUG("SPI::init failed (%i)", ret);
		return ret;
	}

	return Reset() ? 0 : -1;
}

bool ICM42605::Reset()
{
	_state = STATE::RESET;
	DataReadyInterruptDisable();
	ScheduleClear();
	ScheduleNow();
	return true;
}

void ICM42605::exit_and_cleanup()
{
	DataReadyInterruptDisable();
	I2CSPIDriverBase::exit_and_cleanup();
}

void ICM42605::print_status()
{
	I2CSPIDriverBase::print_status();

	PX4_INFO("FIFO empty interval: %d us (%.1f Hz)", _fifo_empty_interval_us, 1e6 / _fifo_empty_interval_us);

	perf_print_counter(_bad_register_perf);
	perf_print_counter(_bad_transfer_perf);
	perf_print_counter(_fifo_empty_perf);
	perf_print_counter(_fifo_overflow_perf);
	perf_print_counter(_fifo_reset_perf);
	perf_print_counter(_drdy_missed_perf);
}

int ICM42605::probe()
{
	for (int i = 0; i < 3; i++) {
		uint8_t whoami = RegisterRead(Register::BANK_0::WHO_AM_I);

		if (whoami == WHOAMI || whoami == WHOAMI_42688P) {
			return PX4_OK;

		} else {
			DEVICE_DEBUG("unexpected WHO_AM_I 0x%02x", whoami);

			uint8_t reg_bank_sel = RegisterRead(Register::BANK_0::REG_BANK_SEL);
			int bank = reg_bank_sel >> 4;

			if (bank >= 1 && bank <= 3) {
				DEVICE_DEBUG("incorrect register bank for WHO_AM_I REG_BANK_SEL:0x%02x, bank:%d", reg_bank_sel, bank);
				// force bank selection and retry
				SelectRegisterBank(REG_BANK_SEL_BIT::USER_BANK_0, true);
			}
		}
	}

	return PX4_ERROR;
}

void ICM42605::RunImpl()
{
	const hrt_abstime now = hrt_absolute_time();

	switch (_state) {
	case STATE::RESET:
		// DEVICE_CONFIG: Software reset configuration
		RegisterWrite(Register::BANK_0::DEVICE_CONFIG, DEVICE_CONFIG_BIT::SOFT_RESET_CONFIG);
		_reset_timestamp = now;
		_failure_count = 0;
		_state = STATE::WAIT_FOR_RESET;
		ScheduleDelayed(1_ms); // wait 1 ms for soft reset to be effective
		break;

	case STATE::WAIT_FOR_RESET:
		if ((RegisterRead(Register::BANK_0::WHO_AM_I) == WHOAMI
		     || RegisterRead(Register::BANK_0::WHO_AM_I) == WHOAMI_42688P)
		    && (RegisterRead(Register::BANK_0::DEVICE_CONFIG) == 0x00)
		    && (RegisterRead(Register::BANK_0::INT_STATUS) & INT_STATUS_BIT::RESET_DONE_INT)) {

			// Wakeup accel and gyro and schedule remaining configuration
			RegisterWrite(Register::BANK_0::PWR_MGMT0, PWR_MGMT0_BIT::GYRO_MODE_LOW_NOISE | PWR_MGMT0_BIT::ACCEL_MODE_LOW_NOISE);
			_state = STATE::CONFIGURE;
			ScheduleDelayed(30_ms); // 30 ms gyro startup time, 10 ms accel from sleep to valid data

		} else {
			// RESET not complete
			if (hrt_elapsed_time(&_reset_timestamp) > 1000_ms) {
				PX4_DEBUG("Reset failed, retrying");
				_state = STATE::RESET;
				ScheduleDelayed(100_ms);

			} else {
				PX4_DEBUG("Reset not complete, check again in 10 ms");
				ScheduleDelayed(10_ms);
			}
		}

		break;

	case STATE::CONFIGURE:
		if (Configure()) {
			// if configure succeeded then start reading from FIFO
			_state = STATE::FIFO_READ;

			if (DataReadyInterruptConfigure()) {
				_data_ready_interrupt_enabled = true;

				// backup schedule as a watchdog timeout
				ScheduleDelayed(100_ms);

			} else {
				_data_ready_interrupt_enabled = false;
				ScheduleOnInterval(_fifo_empty_interval_us, _fifo_empty_interval_us);
			}

			FIFOReset();

		} else {
			// CONFIGURE not complete
			if (hrt_elapsed_time(&_reset_timestamp) > 1000_ms) {
				PX4_DEBUG("Configure failed, resetting");
				_state = STATE::RESET;

			} else {
				PX4_DEBUG("Configure failed, retrying");
			}

			ScheduleDelayed(100_ms);
		}

		break;

	case STATE::FIFO_READ: {
			hrt_abstime timestamp_sample = now;
			uint8_t samples = 0;

			if (_data_ready_interrupt_enabled) {
				// scheduled from interrupt if _drdy_timestamp_sample was set as expected
				const hrt_abstime drdy_timestamp_sample = _drdy_timestamp_sample.fetch_and(0);

				if ((now - drdy_timestamp_sample) < _fifo_empty_interval_us) {
					timestamp_sample = drdy_timestamp_sample;
					samples = _fifo_gyro_samples;

				} else {
					perf_count(_drdy_missed_perf);
				}

				// push backup schedule back
				ScheduleDelayed(_fifo_empty_interval_us * 2);
			}

			if (samples == 0) {
				// check current FIFO count
				const uint16_t fifo_count = FIFOReadCount();

				if (fifo_count >= FIFO::SIZE) {
					FIFOReset();
					perf_count(_fifo_overflow_perf);

				} else if (fifo_count == 0) {
					perf_count(_fifo_empty_perf);

				} else {
					// FIFO count (size in bytes)
					samples = (fifo_count / sizeof(FIFO::DATA));

					// tolerate minor jitter, leave sample to next iteration if behind by only 1
					if (samples == _fifo_gyro_samples + 1) {
						timestamp_sample -= static_cast<int>(FIFO_SAMPLE_DT);
						samples--;
					}

					if (samples > FIFO_MAX_SAMPLES) {
						// not technically an overflow, but more samples than we expected or can publish
						FIFOReset();
						perf_count(_fifo_overflow_perf);
						samples = 0;
					}
				}
			}

			bool success = false;

			if (samples >= 1) {
				if (FIFORead(timestamp_sample, samples)) {
					success = true;

					if (_failure_count > 0) {
						_failure_count--;
					}
				}
			}

			if (!success) {
				_failure_count++;

				// full reset if things are failing consistently
				if (_failure_count > 10) {
					Reset();
					return;
				}
			}

			if (!success || hrt_elapsed_time(&_last_config_check_timestamp) > 100_ms) {
				// check configuration registers periodically or immediately following any failure
				if (RegisterCheck(_register_bank0_cfg[_checked_register_bank0])
				   ) {
					_last_config_check_timestamp = now;
					_checked_register_bank0 = (_checked_register_bank0 + 1) % size_register_bank0_cfg;

				} else {
					// register check failed, force reset
					perf_count(_bad_register_perf);
					Reset();
				}

			} else {
				// periodically update temperature (~1 Hz)
				if (hrt_elapsed_time(&_temperature_update_timestamp) >= 1_s) {
					UpdateTemperature();
					_temperature_update_timestamp = now;
				}
			}
		}

		break;
	}
}

void ICM42605::ConfigureAccel()
{
	const uint8_t ACCEL_FS_SEL = RegisterRead(Register::BANK_0::ACCEL_CONFIG0) & (Bit7 | Bit6 | Bit5); // 7:5 ACCEL_FS_SEL

	switch (ACCEL_FS_SEL) {
	case ACCEL_FS_SEL_2G:
		_px4_accel.set_scale(CONSTANTS_ONE_G / 16384.f);
		_px4_accel.set_range(2.f * CONSTANTS_ONE_G);
		break;

	case ACCEL_FS_SEL_4G:
		_px4_accel.set_scale(CONSTANTS_ONE_G / 8192.f);
		_px4_accel.set_range(4.f * CONSTANTS_ONE_G);
		break;

	case ACCEL_FS_SEL_8G:
		_px4_accel.set_scale(CONSTANTS_ONE_G / 4096.f);
		_px4_accel.set_range(8.f * CONSTANTS_ONE_G);
		break;

	case ACCEL_FS_SEL_16G:
		_px4_accel.set_scale(CONSTANTS_ONE_G / 2048.f);
		_px4_accel.set_range(16.f * CONSTANTS_ONE_G);
		break;
	}
}

void ICM42605::ConfigureGyro()
{
	const uint8_t GYRO_FS_SEL = RegisterRead(Register::BANK_0::GYRO_CONFIG0) & (Bit7 | Bit6 | Bit5); // 7:5 GYRO_FS_SEL

	float range_dps = 0.f;

	switch (GYRO_FS_SEL) {
	case GYRO_FS_SEL_125_DPS:
		range_dps = 125.f;
		break;

	case GYRO_FS_SEL_250_DPS:
		range_dps = 250.f;
		break;

	case GYRO_FS_SEL_500_DPS:
		range_dps = 500.f;
		break;

	case GYRO_FS_SEL_1000_DPS:
		range_dps = 1000.f;
		break;

	case GYRO_FS_SEL_2000_DPS:
		range_dps = 2000.f;
		break;
	}

	_px4_gyro.set_scale(math::radians(range_dps / 32768.f));
	_px4_gyro.set_range(math::radians(range_dps));
}

void ICM42605::ConfigureSampleRate(int sample_rate)
{
	// round down to nearest FIFO sample dt
	const float min_interval = FIFO_SAMPLE_DT;
	_fifo_empty_interval_us = math::max(roundf((1e6f / (float)sample_rate) / min_interval) * min_interval, min_interval);

	_fifo_gyro_samples = roundf(math::min((float)_fifo_empty_interval_us / (1e6f / GYRO_RATE), (float)FIFO_MAX_SAMPLES));

	// recompute FIFO empty interval (us) with actual gyro sample limit
	_fifo_empty_interval_us = _fifo_gyro_samples * (1e6f / GYRO_RATE);

	ConfigureFIFOWatermark(_fifo_gyro_samples);
}

void ICM42605::ConfigureFIFOWatermark(uint8_t samples)
{
	// FIFO watermark threshold in number of bytes
	const uint16_t fifo_watermark_threshold = samples * sizeof(FIFO::DATA);

	for (auto &r : _register_bank0_cfg) {
		if (r.reg == Register::BANK_0::FIFO_CONFIG2) {
			// FIFO_WM[7:0]  FIFO_CONFIG2
			r.set_bits = fifo_watermark_threshold & 0xFF;

		} else if (r.reg == Register::BANK_0::FIFO_CONFIG3) {
			// FIFO_WM[11:8] FIFO_CONFIG3
			r.set_bits = (fifo_watermark_threshold >> 8) & 0x0F;
		}
	}
}

void ICM42605::SelectRegisterBank(enum REG_BANK_SEL_BIT bank, bool force)
{
	if (bank != _last_register_bank || force) {
		// select BANK_0
		uint8_t cmd_bank_sel[2] {};
		cmd_bank_sel[0] = static_cast<uint8_t>(Register::BANK_0::REG_BANK_SEL);
		cmd_bank_sel[1] = bank;
		transfer(cmd_bank_sel, cmd_bank_sel, sizeof(cmd_bank_sel));

		_last_register_bank = bank;
	}
}

bool ICM42605::Configure()
{
	// first set and clear all configured register bits
	for (const auto &reg_cfg : _register_bank0_cfg) {
		RegisterSetAndClearBits(reg_cfg.reg, reg_cfg.set_bits, reg_cfg.clear_bits);
	}

	// now check that all are configured
	bool success = true;

	for (const auto &reg_cfg : _register_bank0_cfg) {
		if (!RegisterCheck(reg_cfg)) {
			success = false;
		}
	}

	ConfigureAccel();
	ConfigureGyro();

	return success;
}

int ICM42605::DataReadyInterruptCallback(int irq, void *context, void *arg)
{
	static_cast<ICM42605 *>(arg)->DataReady();
	return 0;
}

void ICM42605::DataReady()
{
	_drdy_timestamp_sample.store(hrt_absolute_time());
	ScheduleNow();
}

bool ICM42605::DataReadyInterruptConfigure()
{
	if (_drdy_gpio == 0) {
		return false;
	}

	// Setup data ready on falling edge
	return px4_arch_gpiosetevent(_drdy_gpio, false, true, true, &DataReadyInterruptCallback, this) == 0;
}

bool ICM42605::DataReadyInterruptDisable()
{
	if (_drdy_gpio == 0) {
		return false;
	}

	return px4_arch_gpiosetevent(_drdy_gpio, false, false, false, nullptr, nullptr) == 0;
}

template <typename T>
bool ICM42605::RegisterCheck(const T &reg_cfg)
{
	bool success = true;

	const uint8_t reg_value = RegisterRead(reg_cfg.reg);

	if (reg_cfg.set_bits && ((reg_value & reg_cfg.set_bits) != reg_cfg.set_bits)) {
		PX4_DEBUG("0x%02hhX: 0x%02hhX (0x%02hhX not set)", (uint8_t)reg_cfg.reg, reg_value, reg_cfg.set_bits);
		success = false;
	}

	if (reg_cfg.clear_bits && ((reg_value & reg_cfg.clear_bits) != 0)) {
		PX4_DEBUG("0x%02hhX: 0x%02hhX (0x%02hhX not cleared)", (uint8_t)reg_cfg.reg, reg_value, reg_cfg.clear_bits);
		success = false;
	}

	return success;
}

template <typename T>
uint8_t ICM42605::RegisterRead(T reg)
{
	uint8_t cmd[2] {};
	cmd[0] = static_cast<uint8_t>(reg) | DIR_READ;
	SelectRegisterBank(reg);
	transfer(cmd, cmd, sizeof(cmd));
	return cmd[1];
}

template <typename T>
void ICM42605::RegisterWrite(T reg, uint8_t value)
{
	uint8_t cmd[2] { (uint8_t)reg, value };
	SelectRegisterBank(reg);
	transfer(cmd, cmd, sizeof(cmd));
}

template <typename T>
void ICM42605::RegisterSetAndClearBits(T reg, uint8_t setbits, uint8_t clearbits)
{
	const uint8_t orig_val = RegisterRead(reg);

	uint8_t val = (orig_val & ~clearbits) | setbits;

	if (orig_val != val) {
		RegisterWrite(reg, val);
	}
}

uint16_t ICM42605::FIFOReadCount()
{
	// read FIFO count
	uint8_t fifo_count_buf[3] {};
	fifo_count_buf[0] = static_cast<uint8_t>(Register::BANK_0::FIFO_COUNTH) | DIR_READ;
	SelectRegisterBank(REG_BANK_SEL_BIT::USER_BANK_0);

	if (transfer(fifo_count_buf, fifo_count_buf, sizeof(fifo_count_buf)) != PX4_OK) {
		perf_count(_bad_transfer_perf);
		return 0;
	}

	return combine(fifo_count_buf[1], fifo_count_buf[2]);
}

bool ICM42605::FIFORead(const hrt_abstime &timestamp_sample, uint8_t samples)
{
	FIFOTransferBuffer buffer{};
	const size_t transfer_size = math::min(samples * sizeof(FIFO::DATA) + 4, FIFO::SIZE);
	SelectRegisterBank(REG_BANK_SEL_BIT::USER_BANK_0);

	if (transfer((uint8_t *)&buffer, (uint8_t *)&buffer, transfer_size) != PX4_OK) {
		perf_count(_bad_transfer_perf);
		return false;
	}

	if (buffer.INT_STATUS & INT_STATUS_BIT::FIFO_FULL_INT) {
		perf_count(_fifo_overflow_perf);
		FIFOReset();
		return false;
	}

	const uint16_t fifo_count_bytes = combine(buffer.FIFO_COUNTH, buffer.FIFO_COUNTL);

	if (fifo_count_bytes >= FIFO::SIZE) {
		perf_count(_fifo_overflow_perf);
		FIFOReset();
		return false;
	}

	const uint8_t fifo_count_samples = fifo_count_bytes / sizeof(FIFO::DATA);

	if (fifo_count_samples == 0) {
		perf_count(_fifo_empty_perf);
		return false;
	}

	// check FIFO header in every sample
	uint8_t valid_samples = 0;

	for (int i = 0; i < math::min(samples, fifo_count_samples); i++) {
		bool valid = true;

		// With FIFO_ACCEL_EN and FIFO_GYRO_EN header should be 8’b_0110_10xx
		const uint8_t FIFO_HEADER = buffer.f[i].FIFO_Header;

		if (FIFO_HEADER & FIFO::FIFO_HEADER_BIT::HEADER_MSG) {
			// FIFO sample empty if HEADER_MSG set
			valid = false;

		} else if (!(FIFO_HEADER & FIFO::FIFO_HEADER_BIT::HEADER_ACCEL)) {
			// accel bit not set
			valid = false;

		} else if (!(FIFO_HEADER & FIFO::FIFO_HEADER_BIT::HEADER_GYRO)) {
			// gyro bit not set
			valid = false;
		}

		if (valid) {
			valid_samples++;

		} else {
			perf_count(_bad_transfer_perf);
			break;
		}
	}

	if (valid_samples > 0) {
		ProcessGyro(timestamp_sample, buffer.f, valid_samples);
		ProcessAccel(timestamp_sample, buffer.f, valid_samples);
		return true;
	}

	return false;
}

void ICM42605::FIFOReset()
{
	perf_count(_fifo_reset_perf);

	// SIGNAL_PATH_RESET: FIFO flush
	RegisterSetBits(Register::BANK_0::SIGNAL_PATH_RESET, SIGNAL_PATH_RESET_BIT::FIFO_FLUSH);

	// reset while FIFO is disabled
	_drdy_timestamp_sample.store(0);
}

void ICM42605::ProcessAccel(const hrt_abstime &timestamp_sample, const FIFO::DATA fifo[], const uint8_t samples)
{
	sensor_accel_fifo_s accel{};
	accel.timestamp_sample = timestamp_sample;
	accel.samples = 0;
	accel.dt = FIFO_SAMPLE_DT;

	for (int i = 0; i < samples; i++) {
		int16_t accel_x = combine(fifo[i].ACCEL_DATA_X1, fifo[i].ACCEL_DATA_X0);
		int16_t accel_y = combine(fifo[i].ACCEL_DATA_Y1, fifo[i].ACCEL_DATA_Y0);
		int16_t accel_z = combine(fifo[i].ACCEL_DATA_Z1, fifo[i].ACCEL_DATA_Z0);

		// sensor's frame is +x forward, +y left, +z up
		//  flip y & z to publish right handed with z down (x forward, y right, z down)
		accel.x[accel.samples] = accel_x;
		accel.y[accel.samples] = (accel_y == INT16_MIN) ? INT16_MAX : -accel_y;
		accel.z[accel.samples] = (accel_z == INT16_MIN) ? INT16_MAX : -accel_z;
		accel.samples++;
	}

	_px4_accel.set_error_count(perf_event_count(_bad_register_perf) + perf_event_count(_bad_transfer_perf) +
				   perf_event_count(_fifo_empty_perf) + perf_event_count(_fifo_overflow_perf));

	if (accel.samples > 0) {
		_px4_accel.updateFIFO(accel);
	}
}

void ICM42605::ProcessGyro(const hrt_abstime &timestamp_sample, const FIFO::DATA fifo[], const uint8_t samples)
{
	sensor_gyro_fifo_s gyro{};
	gyro.timestamp_sample = timestamp_sample;
	gyro.samples = samples;
	gyro.dt = FIFO_SAMPLE_DT;

	for (int i = 0; i < samples; i++) {
		const int16_t gyro_x = combine(fifo[i].GYRO_DATA_X1, fifo[i].GYRO_DATA_X0);
		const int16_t gyro_y = combine(fifo[i].GYRO_DATA_Y1, fifo[i].GYRO_DATA_Y0);
		const int16_t gyro_z = combine(fifo[i].GYRO_DATA_Z1, fifo[i].GYRO_DATA_Z0);

		// sensor's frame is +x forward, +y left, +z up
		//  flip y & z to publish right handed with z down (x forward, y right, z down)
		gyro.x[i] = gyro_x;
		gyro.y[i] = (gyro_y == INT16_MIN) ? INT16_MAX : -gyro_y;
		gyro.z[i] = (gyro_z == INT16_MIN) ? INT16_MAX : -gyro_z;
	}

	_px4_gyro.set_error_count(perf_event_count(_bad_register_perf) + perf_event_count(_bad_transfer_perf) +
				  perf_event_count(_fifo_empty_perf) + perf_event_count(_fifo_overflow_perf));

	_px4_gyro.updateFIFO(gyro);
}

void ICM42605::UpdateTemperature()
{
	// read current temperature
	uint8_t temperature_buf[3] {};
	temperature_buf[0] = static_cast<uint8_t>(Register::BANK_0::TEMP_DATA1) | DIR_READ;
	SelectRegisterBank(REG_BANK_SEL_BIT::USER_BANK_0);

	if (transfer(temperature_buf, temperature_buf, sizeof(temperature_buf)) != PX4_OK) {
		perf_count(_bad_transfer_perf);
		return;
	}

	const int16_t TEMP_DATA = combine(temperature_buf[1], temperature_buf[2]);

	// Temperature in Degrees Centigrade
	const float TEMP_degC = (TEMP_DATA / TEMPERATURE_SENSITIVITY) + TEMPERATURE_OFFSET;

	if (PX4_ISFINITE(TEMP_degC)) {
		_px4_accel.set_temperature(TEMP_degC);
		_px4_gyro.set_temperature(TEMP_degC);
	}
}
