YangYangyou-Zhang/OpenblH743VIT6/firmware固件/src编译源代码资料/Betafight/patches/sensors/barometer.c

/*
 * This file is part of Cleanflight and Betaflight.
 *
 * Cleanflight and Betaflight are free software. You can redistribute
 * this software and/or modify this software under the terms of the
 * GNU General Public License as published by the Free Software
 * Foundation, either version 3 of the License, or (at your option)
 * any later version.
 *
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
 * If not, see <http://www.gnu.org/licenses/>.
 */

#include <stdbool.h>
#include <stdint.h>
#include <math.h>

#include "platform.h"

#ifdef USE_BARO

#include "build/debug.h"

#include "common/maths.h"
#include "common/filter.h"

#include "pg/pg.h"
#include "pg/pg_ids.h"

#include "drivers/barometer/barometer.h"
#include "drivers/barometer/barometer_bmp085.h"
#include "drivers/barometer/barometer_bmp280.h"
#include "drivers/barometer/barometer_bmp388.h"
#include "drivers/barometer/barometer_dps310.h"
#include "drivers/barometer/barometer_qmp6988.h"
#include "drivers/barometer/barometer_virtual.h"
#include "drivers/barometer/barometer_ms5611.h"
#include "drivers/barometer/barometer_lps.h"
#include "drivers/barometer/barometer_spl06.h"
#include "drivers/barometer/barometer_2smpb_02b.h"
#include "drivers/barometer/barometer_lps22df.h"
#include "drivers/bus.h"
#include "drivers/bus_i2c_busdev.h"
#include "drivers/bus_spi.h"
#include "drivers/io.h"
#include "drivers/time.h"

#include "fc/runtime_config.h"

#include "sensors/sensors.h"

#include "scheduler/scheduler.h"

#include "barometer.h"

baro_t baro;                        // barometer access functions

PG_REGISTER_WITH_RESET_FN(barometerConfig_t, barometerConfig, PG_BAROMETER_CONFIG, 3);

#ifndef DEFAULT_BARO_DEVICE
#define DEFAULT_BARO_DEVICE BARO_DEFAULT
#endif

void pgResetFn_barometerConfig(barometerConfig_t *barometerConfig)
{
    barometerConfig->baro_hardware = DEFAULT_BARO_DEVICE;

    // For backward compatibility; ceate a valid default value for bus parameters
    //
    // 1. If DEFAULT_BARO_xxx is defined, use it.
    // 2. Determine default based on USE_BARO_xxx
    //   a. Precedence is in the order of popularity; BMP388, BMP280, MS5611 then BMP085, then
    //   b. If SPI variant is specified, it is likely onboard, so take it.

#if !(defined(DEFAULT_BARO_SPI_BMP388) || defined(DEFAULT_BARO_BMP388) || defined(DEFAULT_BARO_SPI_BMP280) || \
    defined(DEFAULT_BARO_BMP280) || defined(DEFAULT_BARO_SPI_MS5611) || defined(DEFAULT_BARO_MS5611) || \
    defined(DEFAULT_BARO_BMP085) || defined(DEFAULT_BARO_SPI_LPS) || defined(DEFAULT_BARO_SPI_QMP6988) || \
    defined(DEFAULT_BARO_QMP6988)) || defined(DEFAULT_BARO_DPS310) || defined(DEFAULT_BARO_SPI_DPS310) || \
    defined(DEFAULT_BARO_LPS22DF) || defined(DEFAULT_BARO_SPI_LPS22DF) || defined(DEFAULT_BARO_SPL06)

#if defined(USE_BARO_DPS310) || defined(USE_BARO_SPI_DPS310)
#if defined(USE_BARO_SPI_DPS310)
#define DEFAULT_BARO_SPI_DPS310
#else
#define DEFAULT_BARO_DPS310
#endif
#elif defined(USE_BARO_BMP388) || defined(USE_BARO_SPI_BMP388)
#if defined(USE_BARO_SPI_BMP388)
#define DEFAULT_BARO_SPI_BMP388
#else
#define DEFAULT_BARO_BMP388
#endif
#elif defined(USE_BARO_BMP280) || defined(USE_BARO_SPI_BMP280)
#if defined(USE_BARO_SPI_BMP280)
#define DEFAULT_BARO_SPI_BMP280
#else
#define DEFAULT_BARO_BMP280
#endif
#elif defined(USE_BARO_MS5611) || defined(USE_BARO_SPI_MS5611)
#if defined(USE_BARO_SPI_MS5611)
#define DEFAULT_BARO_SPI_MS5611
#else
#define DEFAULT_BARO_MS5611
#endif
#elif defined(USE_BARO_SPL06)
#define DEFAULT_BARO_SPL06
#elif defined(USE_BARO_QMP6988) || defined(USE_BARO_SPI_QMP6988)
#if defined(USE_BARO_SPI_QMP6988)
#define DEFAULT_BARO_SPI_QMP6988
#else
#define DEFAULT_BARO_QMP6988
#endif
#elif defined(USE_BARO_SPI_LPS)
#define DEFAULT_BARO_SPI_LPS
#elif defined(DEFAULT_BARO_BMP085)
#define DEFAULT_BARO_BMP085
#endif
#elif defined(USE_BARO_2SMBP_02B) || defined(USE_BARO_SPI_2SMBP_02B)
#if defined(USE_BARO_SPI_2SMBP_02B)
#define DEFAULT_BARO_SPI_2SMBP_02B
#else
#define DEFAULT_BARO_2SMBP_02B
#endif
#elif defined(USE_BARO_LPS22DF) || defined(USE_BARO_SPI_LPS22DF)
#if defined(USE_BARO_LPS22DF)
#define DEFAULT_BARO_SPI_LPS22DF
#else
#define DEFAULT_BARO_LPS22DF
#endif
#endif

#ifndef DEFAULT_BARO_I2C_ADDRESS
#define DEFAULT_BARO_I2C_ADDRESS 0
#endif

#if defined(DEFAULT_BARO_SPI_BMP388) || defined(DEFAULT_BARO_SPI_BMP280) || defined(DEFAULT_BARO_SPI_MS5611) || defined(DEFAULT_BARO_SPI_QMP6988) || defined(DEFAULT_BARO_SPI_LPS) || defined(DEFAULT_BARO_SPI_DPS310) || defined(DEFAULT_BARO_SPI_2SMBP_02B)
    barometerConfig->baro_busType = BUS_TYPE_SPI;
    barometerConfig->baro_spi_device = SPI_DEV_TO_CFG(spiDeviceByInstance(BARO_SPI_INSTANCE));
    barometerConfig->baro_spi_csn = IO_TAG(BARO_CS_PIN);
    barometerConfig->baro_i2c_device = I2C_DEV_TO_CFG(I2CINVALID);
    barometerConfig->baro_i2c_address = 0;
#elif defined(DEFAULT_BARO_MS5611) || defined(DEFAULT_BARO_BMP388) || defined(DEFAULT_BARO_BMP280) || defined(DEFAULT_BARO_BMP085) ||defined(DEFAULT_BARO_QMP6988) || defined(DEFAULT_BARO_DPS310) || defined(DEFAULT_BARO_2SMBP_02B) || defined(DEFAULT_BARO_SPL06)
    // All I2C devices shares a default config with address = 0 (per device default)
    barometerConfig->baro_busType = BUS_TYPE_I2C;
    barometerConfig->baro_i2c_device = I2C_DEV_TO_CFG(BARO_I2C_INSTANCE);
    barometerConfig->baro_i2c_address = DEFAULT_BARO_I2C_ADDRESS;
    barometerConfig->baro_spi_device = SPI_DEV_TO_CFG(SPIINVALID);
    barometerConfig->baro_spi_csn = IO_TAG_NONE;
#else
    barometerConfig->baro_hardware = BARO_NONE;
    barometerConfig->baro_busType = BUS_TYPE_NONE;
    barometerConfig->baro_i2c_device = I2C_DEV_TO_CFG(I2CINVALID);
    barometerConfig->baro_i2c_address = 0;
    barometerConfig->baro_spi_device = SPI_DEV_TO_CFG(SPIINVALID);
    barometerConfig->baro_spi_csn = IO_TAG_NONE;
#endif

#ifndef BARO_EOC_PIN
#define BARO_EOC_PIN NONE
#endif

    barometerConfig->baro_eoc_tag = IO_TAG(BARO_EOC_PIN);
    barometerConfig->baro_xclr_tag = IO_TAG(BARO_XCLR_PIN);
}

#define NUM_CALIBRATION_CYCLES   100        // 10 seconds init_delay + 100 * 25 ms = 12.5 seconds before valid baro altitude
#define NUM_GROUND_LEVEL_CYCLES   10        // calibrate baro to new ground level (10 * 25 ms = ~250 ms non blocking)

static uint16_t calibrationCycles = 0;      // baro calibration = get new ground pressure value
static uint16_t calibrationCycleCount = 0;
static float baroGroundAltitude = 0.0f;
static bool baroCalibrated = false;
static bool baroReady = false;

void baroPreInit(void)
{
#ifdef USE_SPI
    if (barometerConfig()->baro_busType == BUS_TYPE_SPI) {
        spiPreinitRegister(barometerConfig()->baro_spi_csn, IOCFG_IPU, 1);
    }
#endif
}

static bool baroDetect(baroDev_t *baroDev, baroSensor_e baroHardwareToUse)
{
    extDevice_t *dev = &baroDev->dev;

    // Detect what pressure sensors are available. baro->update() is set to sensor-specific update function

    baroSensor_e baroHardware = baroHardwareToUse;

#if !defined(USE_BARO_BMP085) && !defined(USE_BARO_MS5611) && !defined(USE_BARO_SPI_MS5611) && !defined(USE_BARO_BMP388) && !defined(USE_BARO_BMP280) && !defined(USE_BARO_SPI_BMP280)&& !defined(USE_BARO_QMP6988) && !defined(USE_BARO_SPI_QMP6988) && !defined(USE_BARO_DPS310) && !defined(USE_BARO_SPI_DPS310) && !defined(DEFAULT_BARO_SPI_2SMBP_02B) && !defined(DEFAULT_BARO_2SMBP_02B) && !defined(USE_BARO_SPL06)
    UNUSED(dev);
#endif

#ifndef USE_VIRTUAL_BARO
    switch (barometerConfig()->baro_busType) {
#ifdef USE_I2C
    case BUS_TYPE_I2C:
        i2cBusSetInstance(dev, barometerConfig()->baro_i2c_device);
        dev->busType_u.i2c.address = barometerConfig()->baro_i2c_address;
        break;
#endif

#ifdef USE_SPI
    case BUS_TYPE_SPI:
        {
            if (!spiSetBusInstance(dev, barometerConfig()->baro_spi_device)) {
                return false;
            }

            dev->busType_u.spi.csnPin = IOGetByTag(barometerConfig()->baro_spi_csn);
        }
        break;
#endif
    default:
        return false;
    }
#endif // USE_VIRTUAL_BARO

    switch (baroHardware) {
    case BARO_DEFAULT:
        FALLTHROUGH;

    case BARO_BMP085:
#ifdef USE_BARO_BMP085
        {
            const bmp085Config_t defaultBMP085Config = {
                .xclrTag = barometerConfig()->baro_xclr_tag,
                .eocTag = barometerConfig()->baro_eoc_tag
            };
            if (bmp085Detect(&defaultBMP085Config, baroDev)) {
                baroHardware = BARO_BMP085;
                break;
            }
        }
#endif
        FALLTHROUGH;

    case BARO_MS5611:
#if defined(USE_BARO_MS5611) || defined(USE_BARO_SPI_MS5611)
        if (ms5611Detect(baroDev)) {
            baroHardware = BARO_MS5611;
            break;
        }
#endif
        FALLTHROUGH;

    case BARO_LPS:
#if defined(USE_BARO_SPI_LPS)
        if (lpsDetect(baroDev)) {
            baroHardware = BARO_LPS;
            break;
        }
#endif
        FALLTHROUGH;

    case BARO_DPS310:
#if defined(USE_BARO_DPS310) || defined(USE_BARO_SPI_DPS310)
        {
            if (baroDPS310Detect(baroDev)) {
                baroHardware = BARO_DPS310;
                break;
            }
        }
#endif
        FALLTHROUGH;

    case BARO_BMP388:
#if defined(USE_BARO_BMP388) || defined(USE_BARO_SPI_BMP388)
        {
            const bmp388Config_t defaultBMP388Config = {
                .eocTag = barometerConfig()->baro_eoc_tag,
            };
            if (bmp388Detect(&defaultBMP388Config, baroDev)) {
                baroHardware = BARO_BMP388;
                break;
            }
        }
#endif
        FALLTHROUGH;

    case BARO_BMP280:
#if defined(USE_BARO_BMP280) || defined(USE_BARO_SPI_BMP280)
        if (bmp280Detect(baroDev)) {
            baroHardware = BARO_BMP280;
            break;
        }
#endif
        FALLTHROUGH;

    case BARO_SPL06:
#if defined(USE_BARO_SPL06)
        if (spl06Detect(baroDev)) {
            baroHardware = BARO_SPL06;
            break;
        }
#endif
        FALLTHROUGH;

     case BARO_QMP6988:
#if defined(USE_BARO_QMP6988) || defined(USE_BARO_SPI_QMP6988)
        if (qmp6988Detect(baroDev)) {
            baroHardware = BARO_QMP6988;
            break;
        }
#endif
        FALLTHROUGH;

     case BARO_2SMPB_02B:
#if defined(USE_BARO_2SMBP_02B) || defined(USE_BARO_SPI_2SMBP_02B)
        if (baro2SMPB02BDetect(baroDev)) {
            baroHardware = BARO_2SMPB_02B;
            break;
        }
#endif
        FALLTHROUGH;

     case BARO_LPS22DF:
#if defined(USE_BARO_LPS22DF) || defined(USE_BARO_SPI_LPS22DF)
        if (lps22dfDetect(baroDev)) {
            baroHardware = BARO_LPS22DF;
            break;
        }
#endif
        FALLTHROUGH;

    case BARO_VIRTUAL:
#ifdef USE_VIRTUAL_BARO
        if (virtualBaroDetect(baroDev)) {
            baroHardware = BARO_VIRTUAL;
            break;
        }
#endif
        FALLTHROUGH;

    case BARO_NONE:
        baroHardware = BARO_NONE;
        break;
    }

    if (baroHardware == BARO_NONE) {
        return false;
    }

    detectedSensors[SENSOR_INDEX_BARO] = baroHardware;
    sensorsSet(SENSOR_BARO);
    return true;
}

void baroInit(void)
{
#ifndef USE_VIRTUAL_BARO
    baroReady = baroDetect(&baro.dev, barometerConfig()->baro_hardware);
#else
    baroReady = baroDetect(&baro.dev, BARO_VIRTUAL);
#endif
}

bool baroIsCalibrated(void)
{
    return baroCalibrated;
}

void baroStartCalibration(void)
{
    baroGroundAltitude = 0;
    baroCalibrated = false;
    calibrationCycles = NUM_CALIBRATION_CYCLES;
    calibrationCycleCount = 0;
}

void baroSetGroundLevel(void)
{
    baroGroundAltitude = 0;
    baroCalibrated = false;
    calibrationCycles = NUM_GROUND_LEVEL_CYCLES;
    calibrationCycleCount = 0;
}

typedef enum {
    BARO_STATE_TEMPERATURE_READ = 0,
    BARO_STATE_TEMPERATURE_SAMPLE,
    BARO_STATE_PRESSURE_START,
    BARO_STATE_PRESSURE_READ,
    BARO_STATE_PRESSURE_SAMPLE,
    BARO_STATE_TEMPERATURE_START,
    BARO_STATE_COUNT
} barometerState_e;


bool isBaroReady(void)
{
    return baroReady;
}

static float pressureToAltitude(const float pressure)
{
    return (1.0f - powf(pressure / 101325.0f, 0.190295f)) * 4433000.0f;
}

static void performBaroCalibrationCycle(const float altitude);

uint32_t baroUpdate(timeUs_t currentTimeUs)
{
    static timeUs_t baroStateDurationUs[BARO_STATE_COUNT];
    static barometerState_e state = BARO_STATE_PRESSURE_START;
    barometerState_e oldState = state;
    timeUs_t executeTimeUs;
    timeUs_t sleepTime = 1000; // Wait 1ms between states

    DEBUG_SET(DEBUG_BARO, 0, state);

    if (busBusy(&baro.dev.dev, NULL)) {
        // If the bus is busy, simply return to have another go later
        schedulerIgnoreTaskStateTime();
        return sleepTime;
    }

    switch (state) {
        default:
        case BARO_STATE_TEMPERATURE_START:
            baro.dev.start_ut(&baro.dev);
            state = BARO_STATE_TEMPERATURE_READ;
            sleepTime = baro.dev.ut_delay;
            break;

        case BARO_STATE_TEMPERATURE_READ:
            if (baro.dev.read_ut(&baro.dev)) {
                state = BARO_STATE_TEMPERATURE_SAMPLE;
            } else {
                // No action was taken as the read has not completed
                schedulerIgnoreTaskExecTime();
            }
            break;

        case BARO_STATE_TEMPERATURE_SAMPLE:
            if (baro.dev.get_ut(&baro.dev)) {
                state = BARO_STATE_PRESSURE_START;
            } else {
                // No action was taken as the read has not completed
                schedulerIgnoreTaskExecTime();
            }
            break;

        case BARO_STATE_PRESSURE_START:
            baro.dev.start_up(&baro.dev);
            state = BARO_STATE_PRESSURE_READ;
            sleepTime = baro.dev.up_delay;
            break;

        case BARO_STATE_PRESSURE_READ:
            if (baro.dev.read_up(&baro.dev)) {
                state = BARO_STATE_PRESSURE_SAMPLE;
            } else {
                // No action was taken as the read has not completed
                schedulerIgnoreTaskExecTime();
            }
            break;

        case BARO_STATE_PRESSURE_SAMPLE:
            if (!baro.dev.get_up(&baro.dev)) {
                // No action was taken as the read has not completed
                schedulerIgnoreTaskExecTime();
                break;
            }

            // update baro data
            baro.dev.calculate(&baro.pressure, &baro.temperature);

            // If baro.pressure is invalid then skip altitude counting / call of calibration cycle
            if (baro.pressure > 0) {
                const float altitude = pressureToAltitude(baro.pressure);
                if (baroIsCalibrated()) {
                    // zero baro altitude
                    baro.altitude = altitude - baroGroundAltitude;
                } else {
                    // establish stable baroGroundAltitude value to zero baro altitude with
                    performBaroCalibrationCycle(altitude);
                    baro.altitude = 0.0f;
                }
            } else {
                // return 0 during calibration, reuse last value otherwise
                if (!baroIsCalibrated()) {
                    baro.altitude = 0.0f;
                }
            }

            if (debugMode == DEBUG_BARO) {
                DEBUG_SET(DEBUG_BARO, 1, lrintf(baro.pressure / 100.0f));   // hPa
                DEBUG_SET(DEBUG_BARO, 2, baro.temperature);                 // c°C
                DEBUG_SET(DEBUG_BARO, 3, lrintf(baro.altitude));            // cm
            }

            if (baro.dev.combined_read) {
                state = BARO_STATE_PRESSURE_START;
            } else {
                state = BARO_STATE_TEMPERATURE_START;
            }
            break;
    }

    // Where we are using a state machine call schedulerIgnoreTaskExecRate() for all states bar one
    if (state != BARO_STATE_PRESSURE_START) {
        schedulerIgnoreTaskExecRate();
    }

    executeTimeUs = micros() - currentTimeUs;

    if (executeTimeUs > baroStateDurationUs[oldState]) {
        baroStateDurationUs[oldState] = executeTimeUs;
    }

    schedulerSetNextStateTime(baroStateDurationUs[state]);

    return sleepTime;
}

float getBaroAltitude(void)
{
    return baro.altitude;
}

static void performBaroCalibrationCycle(const float altitude)
{
    baroGroundAltitude += altitude;
    calibrationCycleCount++;

    if (calibrationCycleCount >= calibrationCycles) {
        baroGroundAltitude /= calibrationCycleCount;  // simple average
        baroCalibrated = true;
        calibrationCycleCount = 0;
    }
}

#endif /* BARO */
