YangYangyou-Zhang/OpenblH743VIT6/firmware固件/src编译源代码资料/PX4/openblh743/src/init.c

/****************************************************************************
 *
 *   Copyright (c) 2021 PX4 Development Team. All rights reserved.
 *   Copyright (c) 2026 洋洋柚 (@zhangyangyangyou)
 *   Modified for the OpenblH743VIT6 board.
 *
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
 * 1. Redistributions of source code must retain the above copyright
 *    notice, this list of conditions and the following disclaimer.
 * 2. Redistributions in binary form must reproduce the above copyright
 *    notice, this list of conditions and the following disclaimer in
 *    the documentation and/or other materials provided with the
 *    distribution.
 * 3. Neither the name PX4 nor the names of its contributors may be
 *    used to endorse or promote products derived from this software
 *    without specific prior written permission.
 *
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
 ****************************************************************************/

/**
 * @file init.c
 *
 * FMU-specific early startup code. This file implements the
 * board_app_initialize() function that is called early by nsh during startup.
 *
 * Code here is run before the rcS script is invoked; it should start required
 * subsystems and perform board-specific initialisation.
 */

#include "board_config.h"

#include <syslog.h>

#include <nuttx/config.h>
#include <nuttx/board.h>
#include <nuttx/sdio.h>
#include <nuttx/mmcsd.h>
#include <arch/board/board.h>
#include "arm_internal.h"

#include <drivers/drv_hrt.h>
#include <drivers/drv_board_led.h>
#include <systemlib/px4_macros.h>
#include <px4_arch/io_timer.h>
#include <px4_platform_common/init.h>
#include <px4_platform/gpio.h>
#include <px4_platform/board_dma_alloc.h>
#include <stm32_otg.h>

# if defined(FLASH_BASED_PARAMS)
#  include <parameters/flashparams/flashfs.h>
#endif

__BEGIN_DECLS
extern void led_init(void);
extern void led_on(int led);
extern void led_off(int led);
__END_DECLS

/************************************************************************************
 * Name: board_peripheral_reset
 *
 * Description:
 *
 ************************************************************************************/
__EXPORT void board_peripheral_reset(int ms)
{
	UNUSED(ms);
}

/************************************************************************************
 * Name: board_on_reset
 *
 * Description:
 * Optionally provided function called on entry to board_system_reset
 * It should perform any house keeping prior to the rest.
 *
 * status - 1 if resetting to boot loader
 *          0 if just resetting
 *
 ************************************************************************************/
__EXPORT void board_on_reset(int status)
{
	for (int i = 0; i < DIRECT_PWM_OUTPUT_CHANNELS; ++i) {
		px4_arch_configgpio(PX4_MAKE_GPIO_INPUT(io_timer_channel_get_as_pwm_input(i)));
	}

	/*
	 * On resets invoked from system (not boot) ensure we establish a low
	 * output state on PWM pins to disarm the ESC and prevent the reset from potentially
	 * spinning up the motors.
	 */
	if (status >= 0) {
		up_mdelay(100);
	}
}

/************************************************************************************
 * Name: stm32_boardinitialize
 *
 * Description:
 *   All STM32 architectures must provide the following entry point.  This entry point
 *   is called early in the initialization -- after all memory has been configured
 *   and mapped but before any devices have been initialized.
 *
 ************************************************************************************/
__EXPORT void stm32_boardinitialize(void)
{
	/* Reset PWM first thing */
	board_on_reset(-1);

	/* configure LEDs */
	board_autoled_initialize();

	/* configure pins */
	const uint32_t gpio[] = PX4_GPIO_INIT_LIST;
	px4_gpio_init(gpio, arraySize(gpio));

	/* configure SPI interfaces */
	stm32_spiinitialize();

	/* configure USB interfaces */
	stm32_usbinitialize();

}

/****************************************************************************
 * Name: board_app_initialize
 *
 * Description:
 *   Perform application specific initialization.  This function is never
 *   called directly from application code, but only indirectly via the
 *   (non-standard) boardctl() interface using the command BOARDIOC_INIT.
 *
 * Input Parameters:
 *   arg - The boardctl() argument is passed to the board_app_initialize()
 *         implementation without modification.  The argument has no
 *         meaning to NuttX;
 *
 * Returned Value:
 *   Zero (OK) is returned on success; a negated errno value is returned on
 *   any failure to indicate the nature of the failure.
 *
 ****************************************************************************/
__EXPORT int board_app_initialize(uintptr_t arg)
{
	/* Need hrt running before using the ADC */
	px4_platform_init();

	/* configure the DMA allocator */
	if (board_dma_alloc_init() < 0) {
		syslog(LOG_ERR, "[boot] DMA alloc FAILED\n");
	}

	/* initial LED state */
	drv_led_start();
	led_off(LED_RED);
	led_off(LED_BLUE);

	if (board_hardfault_init(2, true) != 0) {
		led_on(LED_BLUE);
	}

#ifdef CONFIG_MMCSD
	int ret = stm32_sdio_initialize();

	if (ret != OK) {
		led_on(LED_BLUE);
		return ret;
	}

#endif

// TODO：internal flash store parameters
#if defined(FLASH_BASED_PARAMS)
	static sector_descriptor_t params_sector_map[] = {
		{15, 128 * 1024, 0x081E0000},
		{0, 0, 0},
	};

	/* Initialize the flashfs layer to use heap allocated memory */
	int result = parameter_flashfs_init(params_sector_map, NULL, 0);

	if (result != OK) {
		syslog(LOG_ERR, "[boot] FAILED to init params in FLASH %d\n", result);
		led_on(LED_RED);
	}

#endif

	/* Configure the HW based on the manifest */
	px4_platform_configure();

	return OK;
}
void board_late_initialize(void)
{
	uint32_t gusbcfg = getreg32(STM32_OTG_GUSBCFG);
	gusbcfg |= OTG_GUSBCFG_FDMOD;
	putreg32(gusbcfg, STM32_OTG_GUSBCFG);
	uint32_t gccfg = getreg32(STM32_OTG_GCCFG);
	gccfg &= ~OTG_GCCFG_VBDEN;
	putreg32(gccfg, STM32_OTG_GCCFG);
}
