YangYangyou-Zhang/OpenblH743VIT6/firmware固件/src编译源代码资料/Betafight/patches/sensors/compass.h

/*
 * This file is part of Cleanflight and Betaflight.
 *
 * Cleanflight and Betaflight are free software. You can redistribute
 * this software and/or modify this software under the terms of the
 * GNU General Public License as published by the Free Software
 * Foundation, either version 3 of the License, or (at your option)
 * any later version.
 *
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
 * If not, see <http://www.gnu.org/licenses/>.
 */

#pragma once

#include "common/time.h"
#include "common/sensor_alignment.h"
#include "drivers/io_types.h"
#include "drivers/sensor.h"
#include "pg/pg.h"
#include "sensors/sensors.h"

#define TASK_COMPASS_RATE_HZ 40 // the base mag update rate; faster intervals will apply for higher ODR mags

// Type of magnetometer used/detected
typedef enum {
    MAG_DEFAULT = 0,
    MAG_NONE = 1,
    MAG_HMC5883 = 2,
    MAG_AK8975 = 3,
    MAG_AK8963 = 4,
    MAG_QMC5883 = 5,
    MAG_LIS2MDL = 6,
    MAG_LIS3MDL = 7,
    MAG_MPU925X_AK8963 = 8,
    MAG_IST8310 = 9,
    MAG_QMC5883P = 10,
} magSensor_e;

typedef struct mag_s {
    bool isNewMagADCFlag;
    float magADC[XYZ_AXIS_COUNT];
} mag_t;

extern mag_t mag;

typedef struct compassConfig_s {
    uint8_t mag_alignment;                  // mag alignment
    uint8_t mag_hardware;                   // Which mag hardware to use on boards with more than one device
    uint8_t mag_busType;
    uint8_t mag_i2c_device;
    uint8_t mag_i2c_address;
    uint8_t mag_spi_device;
    ioTag_t mag_spi_csn;
    ioTag_t interruptTag;
    flightDynamicsTrims_t magZero;
    sensorAlignment_t mag_customAlignment;
} compassConfig_t;

typedef struct compassBiasEstimator_s {
    float lambda_min, lambda;
    float b[3];
    float theta[4];
    float U[4][4];
    float D[4];
} compassBiasEstimator_t;

PG_DECLARE(compassConfig_t, compassConfig);

bool compassIsHealthy(void);
uint32_t compassUpdate(timeUs_t currentTime);
bool compassInit(void);
void compassPreInit(void);
void compassStartCalibration(void);
bool compassIsCalibrationComplete(void);
void compassBiasEstimatorInit(compassBiasEstimator_t *compassBiasEstimator, const float lambda_min, const float p0);
void compassBiasEstimatorUpdate(compassBiasEstimator_t *compassBiasEstimator, const float lambda_min, const float p0);
void compassBiasEstimatorApply(compassBiasEstimator_t *cBE, float *mag);
