YangYangyou-Zhang/OpenblH743VIT6/(commit log)

2026-10-23 Initial commit: OpenblH743VIT6 hardware, firmware and documentation
    Hardware design (schematics/PCB/BOM/Gerber), mechanical models,
    PX4/ArduPilot/Betaflight/INAV board ports and prebuilt firmware,
    parameter packages, licensing and bilingual documentation.
    [BOM_OpenblH743MINI飞控板_2026-09-29.csv, BOM_OpenblH743VIT6飞控板_2026-09-29.csv, OpenblH743.SLDPRT, OpenblH743.STL, OpenblH743_3507.SLDPRT, OpenblH743_3507.STL, OpenblH743_3507_L.SLDPRT, OpenblH743_3507_L.STL]
2026-10-23 Add interface maps and annotated board images
    Map every serial/comm connector on the VIT6 and MINI boards to
    PX4 (GPS/TELEM/RC/URT6), ArduPilot SERIALn and Betaflight/INAV UARTn,
    with four annotated board images and bilingual reference documents.
2026-10-23 Fix interface map callout positions and MINI ESC labels
    Re-derive connector coordinates from the pick-and-place files and image
    detection so the callouts sit on the actual connectors. Relabel the MINI
    rear connectors as 4-in-1 ESC S1-S4 (U16) and S5-S8 (U19), both carrying
    RX7/UART7 telemetry.
2026-10-23 Bilingual interface maps at 2x, label DJI HD VTX port
    Add Chinese/English titles and notes to all four annotated images,
    double the output resolution for crisp text, and label the USART6 +
    USART2 + VCC connector (VIT6 U15, MINI U17) as the DJI HD VTX port.
2026-10-24 Betaflight H743: add SPL06 barometer and QMC5883P compass support
    Port the INAV SPL06 and QMC5883P drivers to Betaflight 4.5.3, enable
    USE_BARO/USE_MAG in the target config, document the patch set and build,
    and refresh the prebuilt firmware.
2026-10-24 INAV H743: document serial map, I2C addresses and limitations
    Add the UART map and interface-map links, I2C addresses for SPL06/QMC5883P,
    compass calibration notes, enabled features, known limitations (single IMU,
    no CAN, PB0/PB1 PWM, bootloader overwrite) and the GCC/Ruby build note.
