YangYangyou-Zhang/OpenblH743VIT6/(notices)

Notices in the files:
firmware固件/src编译源代码资料/INAV/OpenblH743VIT6/target.h:
INAV is free software: you can redistribute it and/or modify
it under the terms of the GNU General Public License as published by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
